tylerssims/psa_display_pedestal/README.md

# psa_display_pedestal
 Project files for a digital psa card display.
