tylerssims/psa_display_pedestal/psa_display_pedestal/drawings/.PNG/aluminum_pedestal_REVA.png

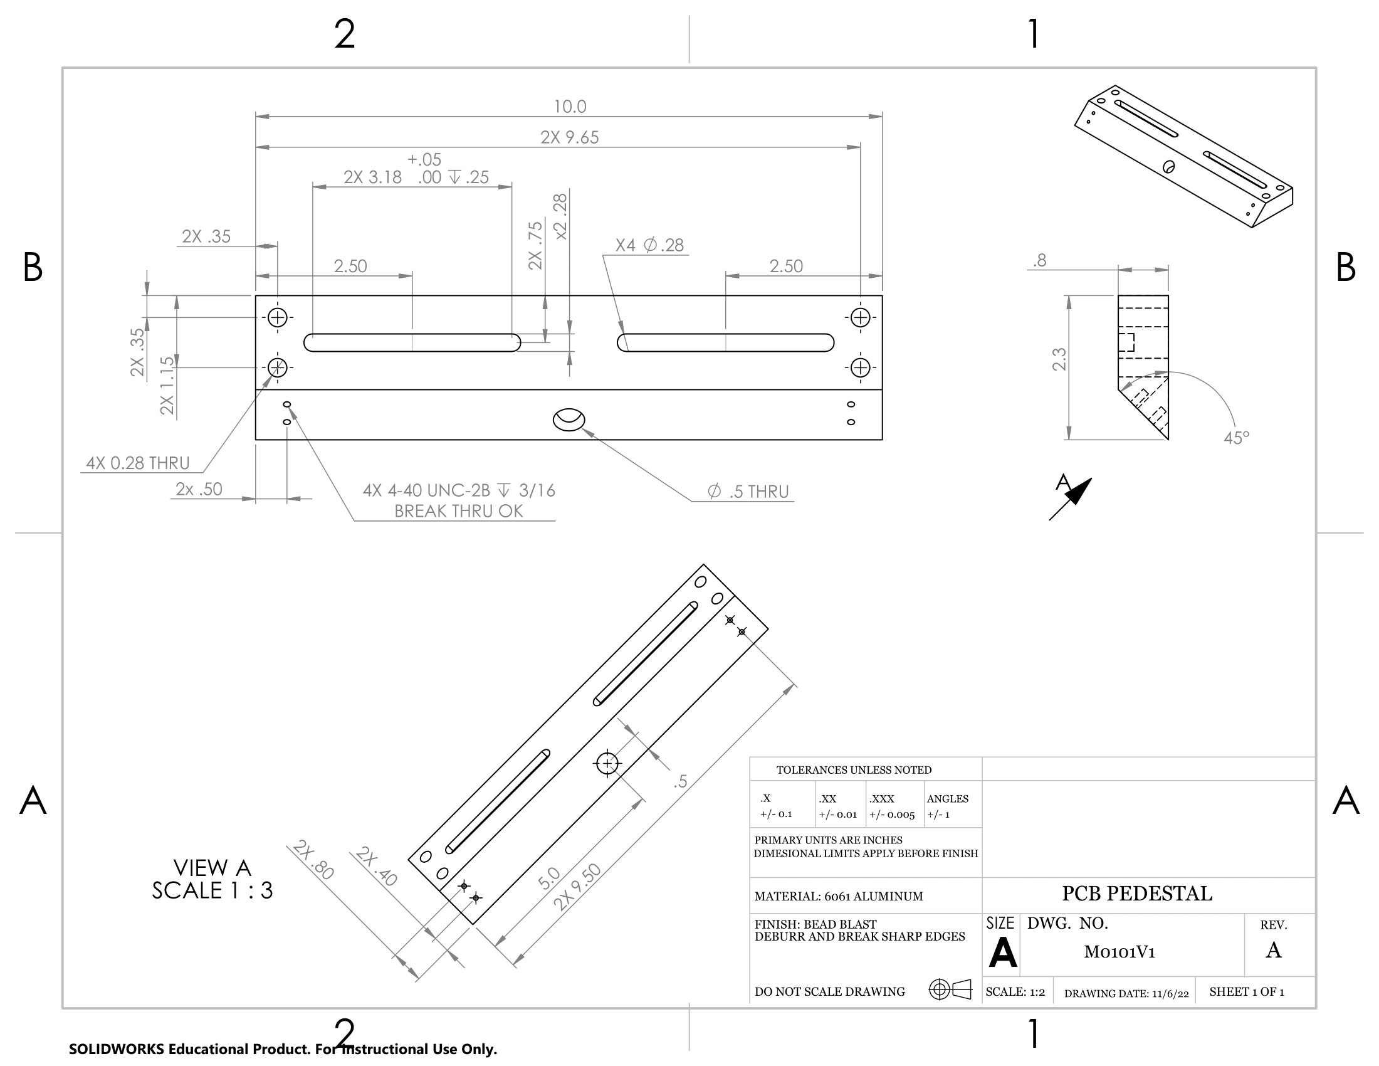
psa_display_pedestal/drawings/.PNG/aluminum_pedestal_REVA.png
