tylerssims/psa_display_pedestal/psa_display_pedestal/drawings/.PNG/front_panel_pcb_schematic_sch_bw.png

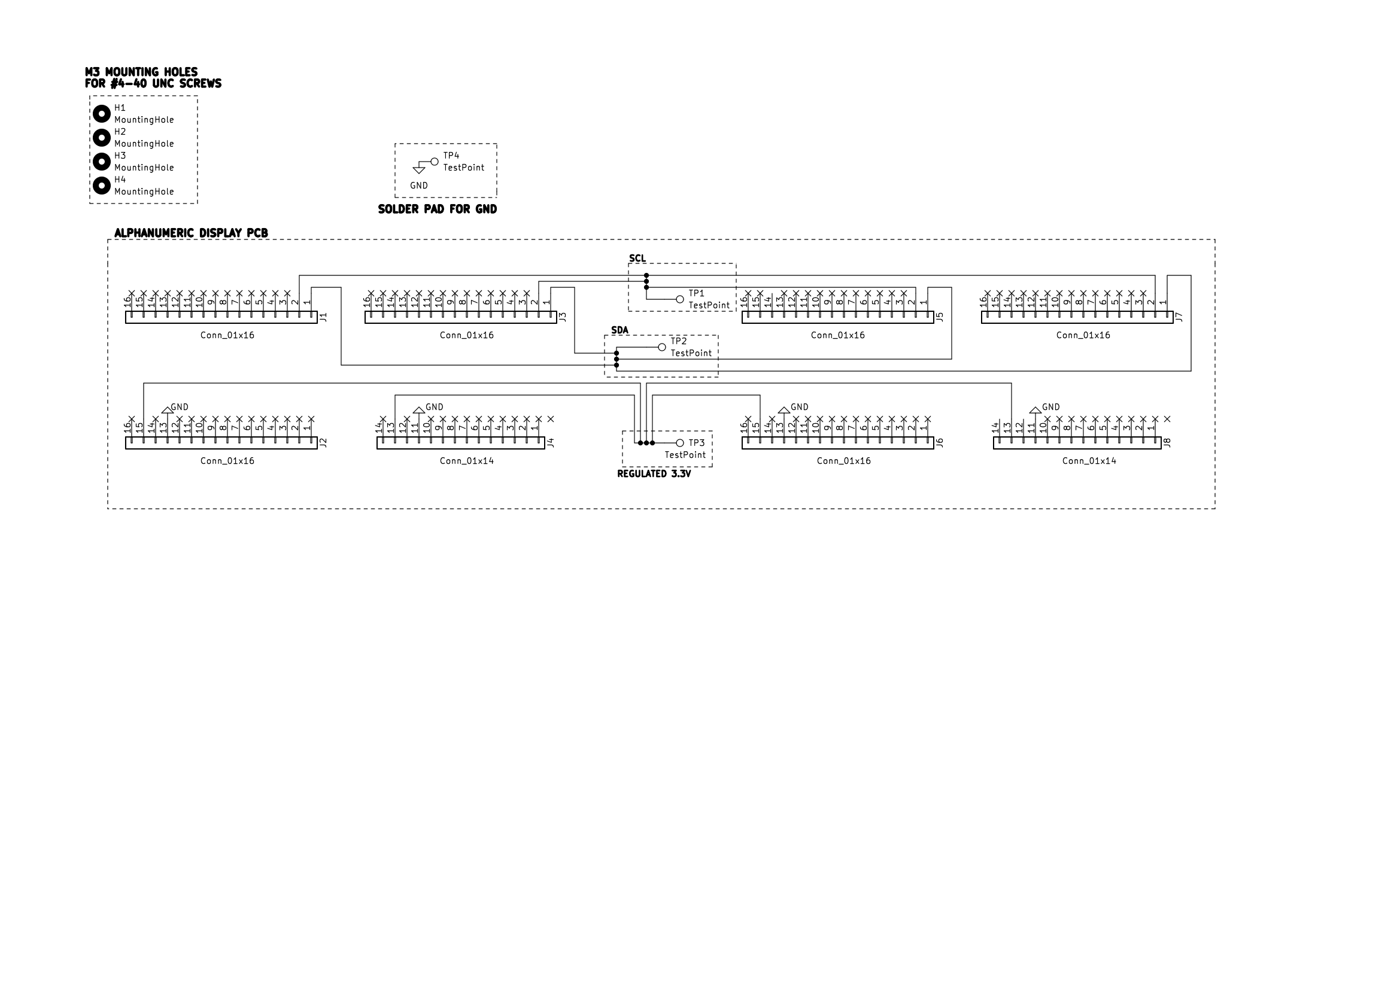
psa_display_pedestal/drawings/.PNG/front_panel_pcb_schematic_sch_bw.png
