tylerssims/psa_display_pedestal/psa_display_pedestal/drawings/.PNG/huzzah_control_pcb_sch_bw.png

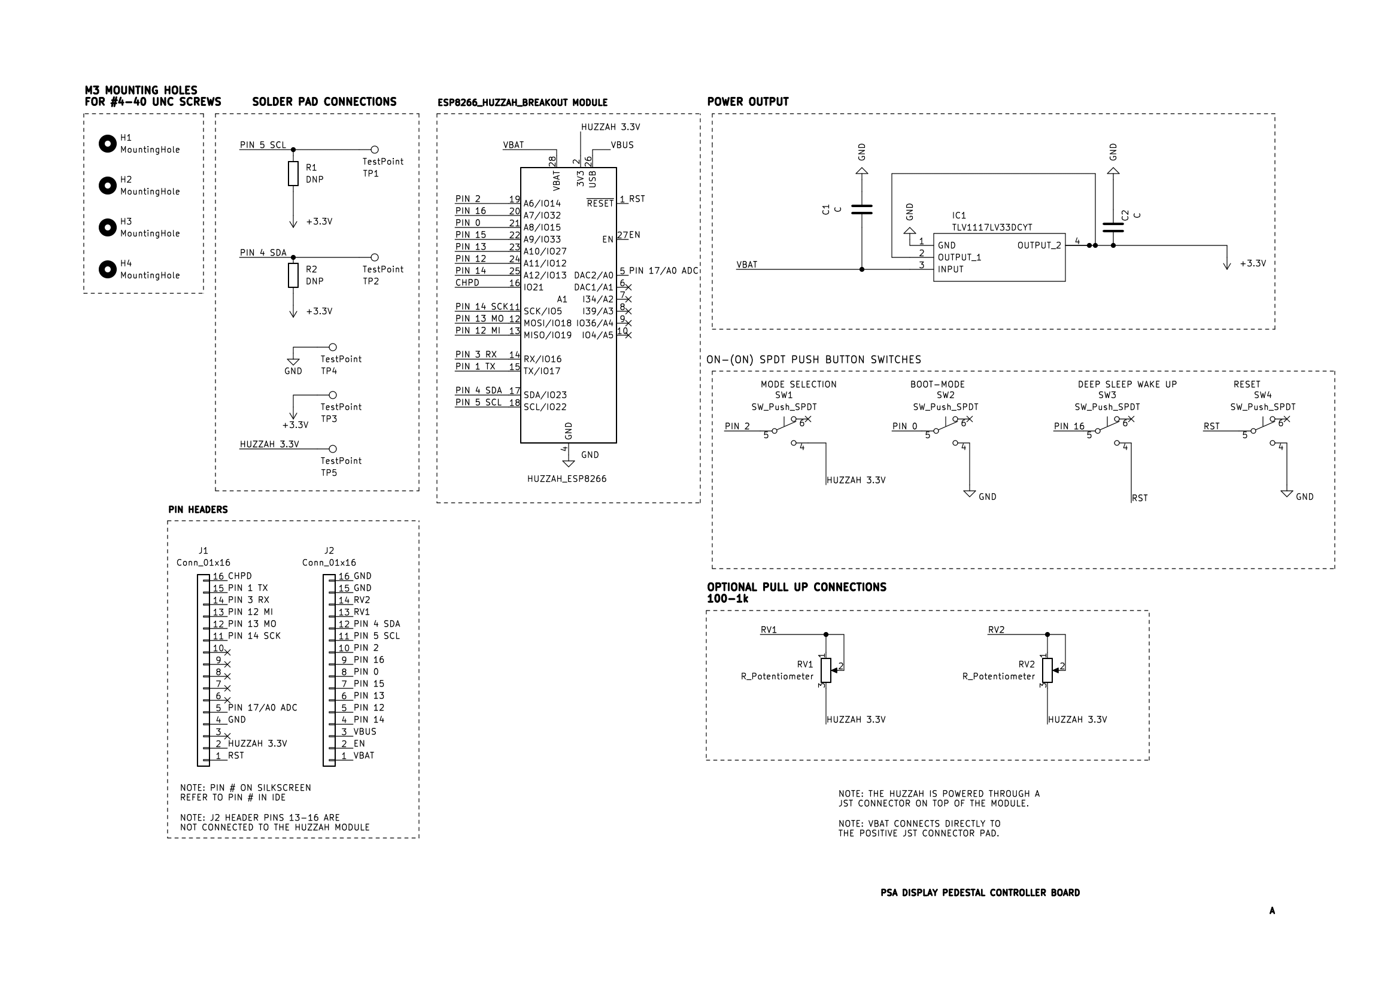
psa_display_pedestal/drawings/.PNG/huzzah_control_pcb_sch_bw.png
