tylerssims/psa_display_pedestal/psa_display_pedestal/drawings/.PNG/pla_back.png

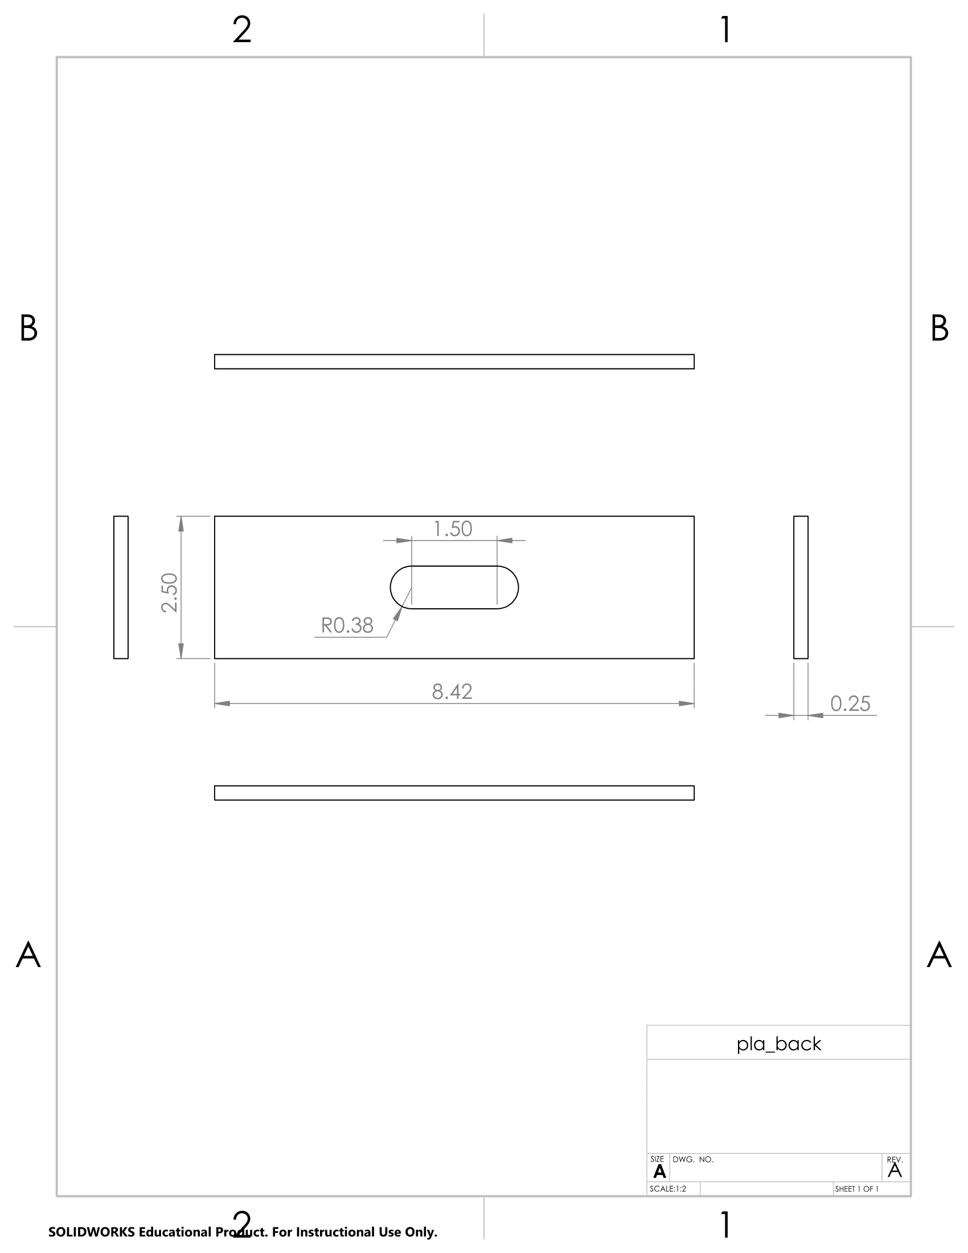
psa_display_pedestal/drawings/.PNG/pla_back.png
