tylerssims/psa_display_pedestal/psa_display_pedestal/drawings/.PNG/pla_side_LHS.png

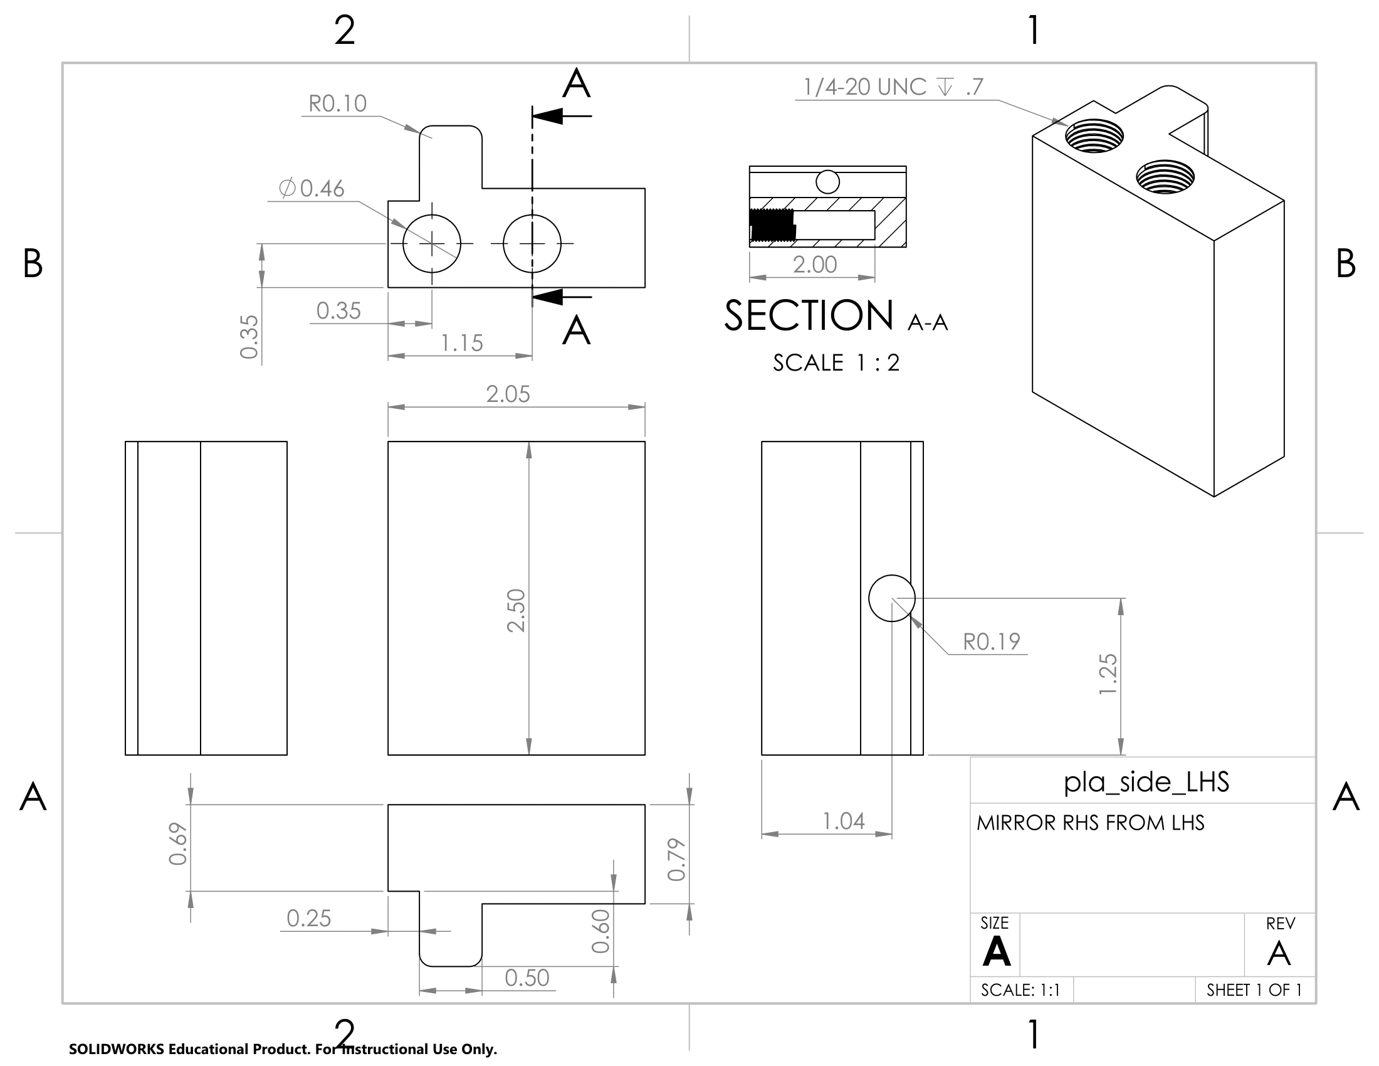
psa_display_pedestal/drawings/.PNG/pla_side_LHS.png
