tylerssims/psa_display_pedestal/psa_display_pedestal/drawings/.PNG/wood_bottom.png

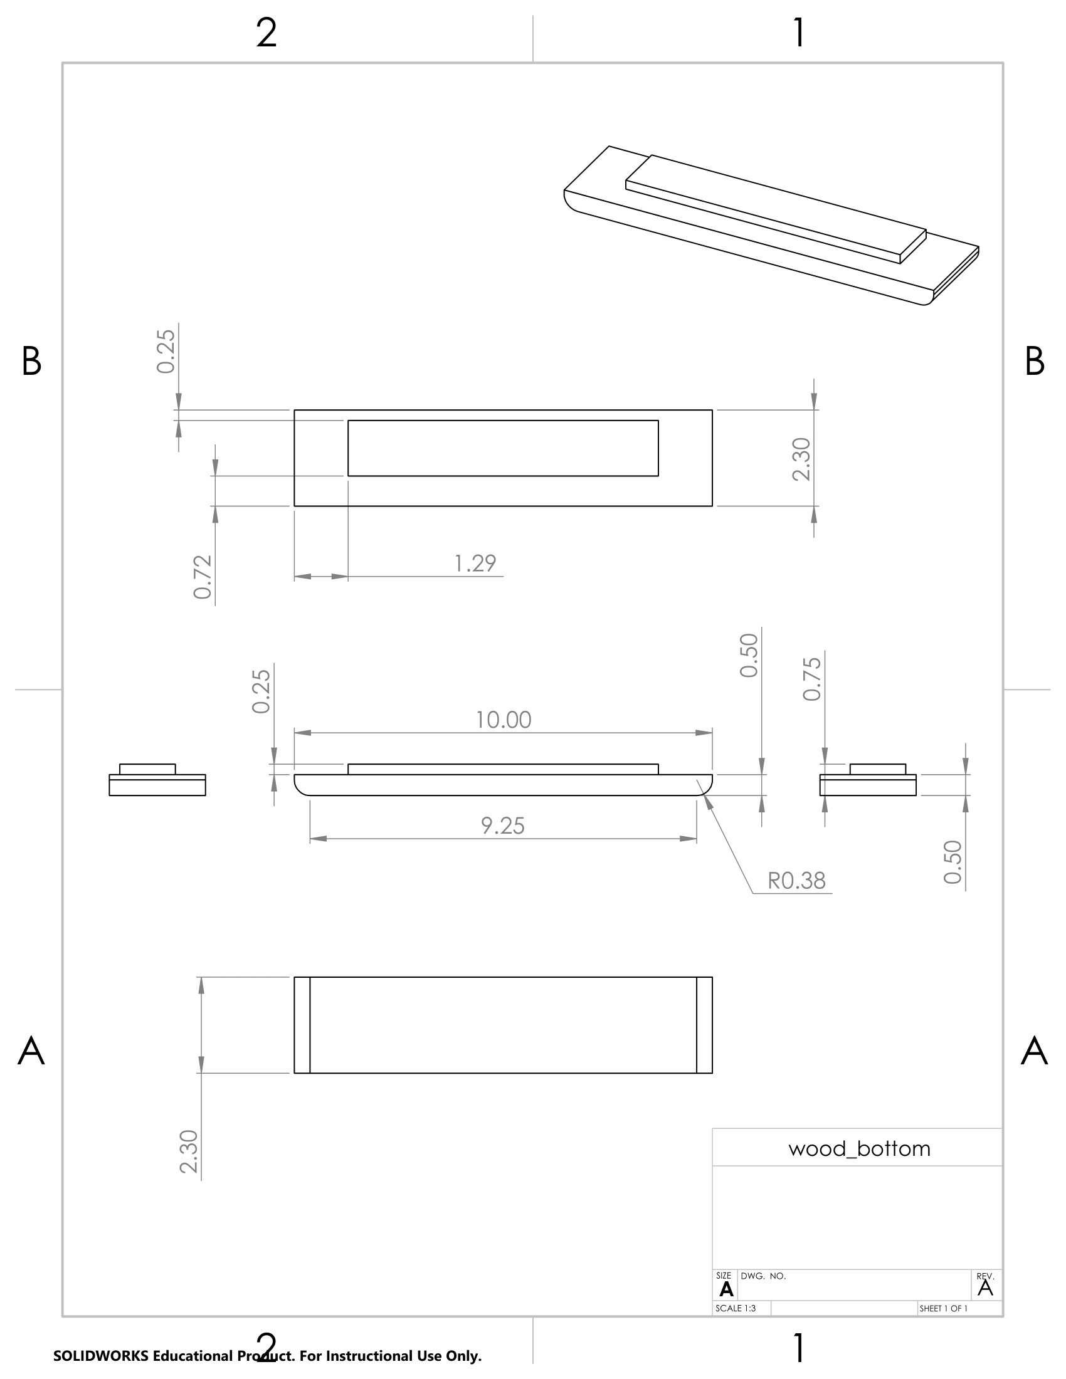
psa_display_pedestal/drawings/.PNG/wood_bottom.png
