tylerssims/psa_display_pedestal/psa_display_pedestal/drawings/.PNG/wood_front.png

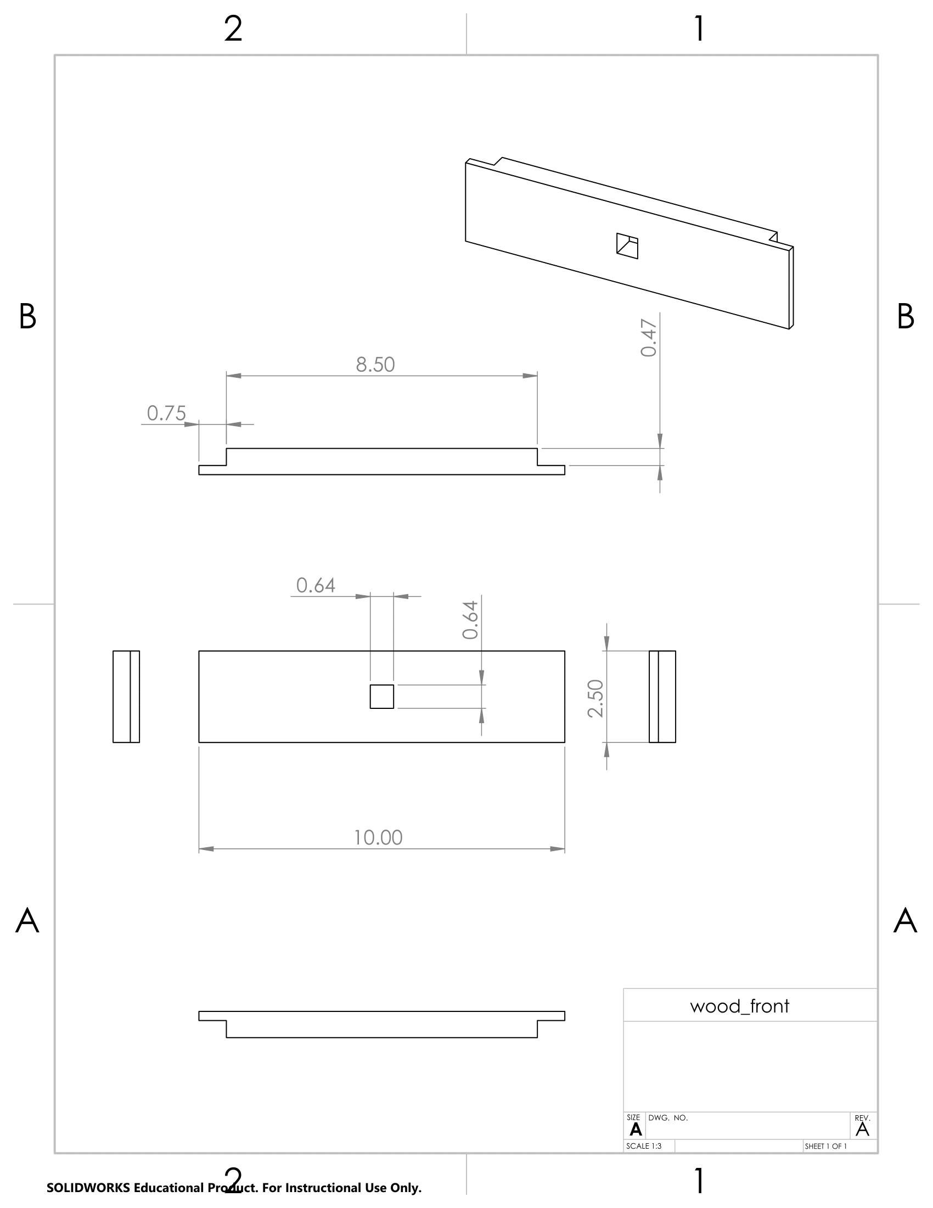
psa_display_pedestal/drawings/.PNG/wood_front.png
