tylerssims/psa_display_pedestal/psa_display_pedestal/images/BOM.png

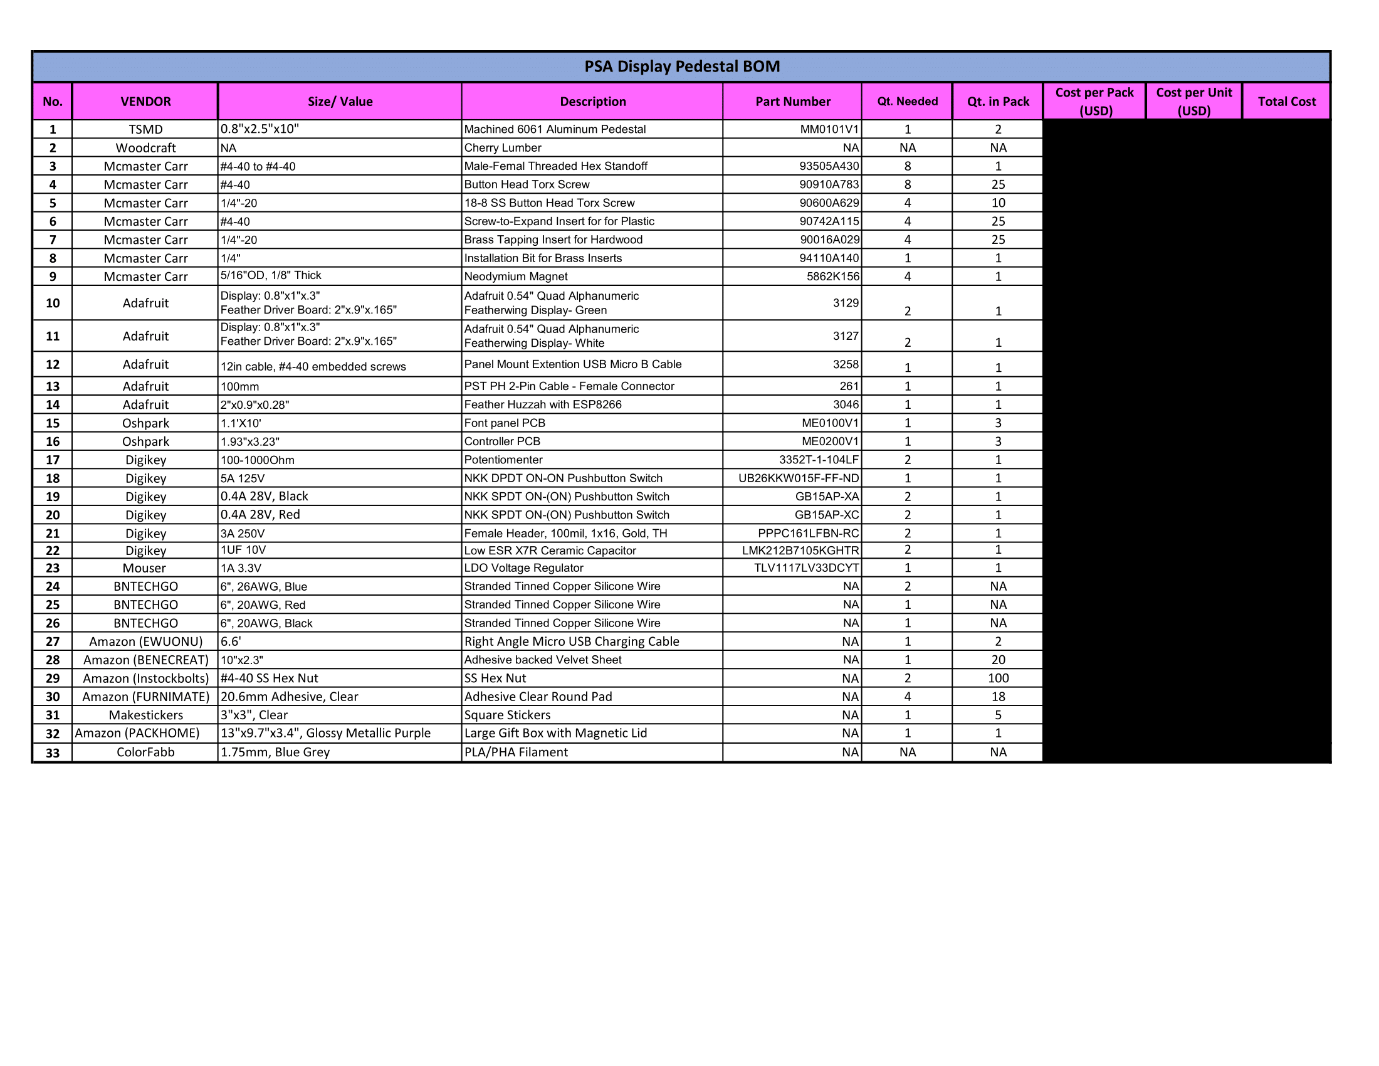
psa_display_pedestal/images/BOM.png
