tylerssims/psa_display_pedestal/psa_display_pedestal/3d_models/.SLDPRT/NKKSWITCHES_UB26KKW015FFF/UB26KKW015F_FF.sldasm

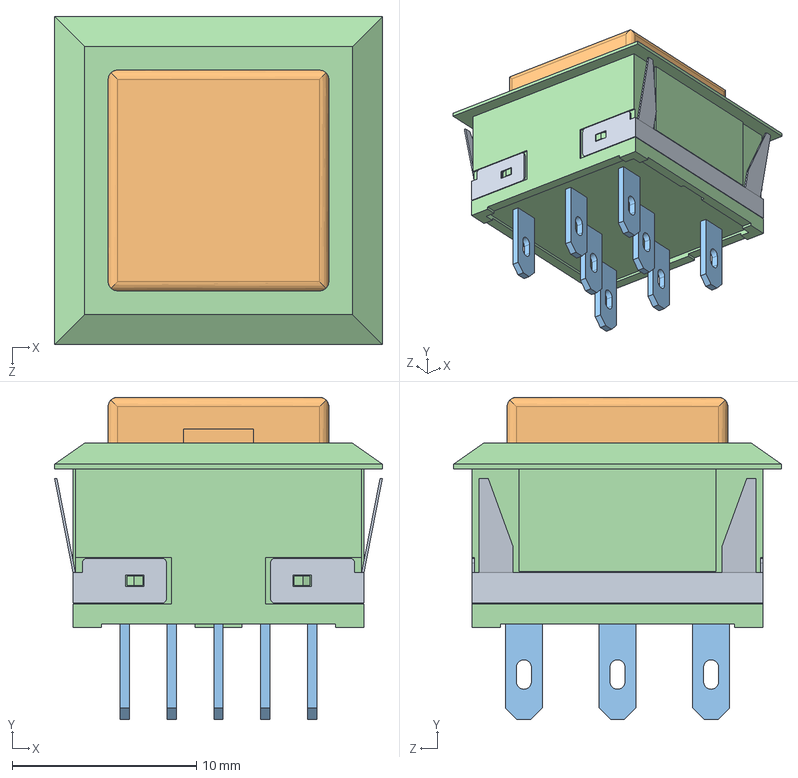
[picture p9: CAD file, 2023-03-03]
psa_display_pedestal/3d_models/.SLDPRT/NKKSWITCHES_UB26KKW015FFF/UB26KKW015F_FF.sldasm
17.8 x 17.5 x 17.8 mm
UB26KKW015F_FF_3 x 2
UB26KKW015F_FF_6
UB26KKW015F_FF_8 x 8
UB26KKW015F_FF_17
