tylerssims/psa_display_pedestal/psa_display_pedestal/3d_models/.SLDPRT/front_panel_assembly.SLDASM

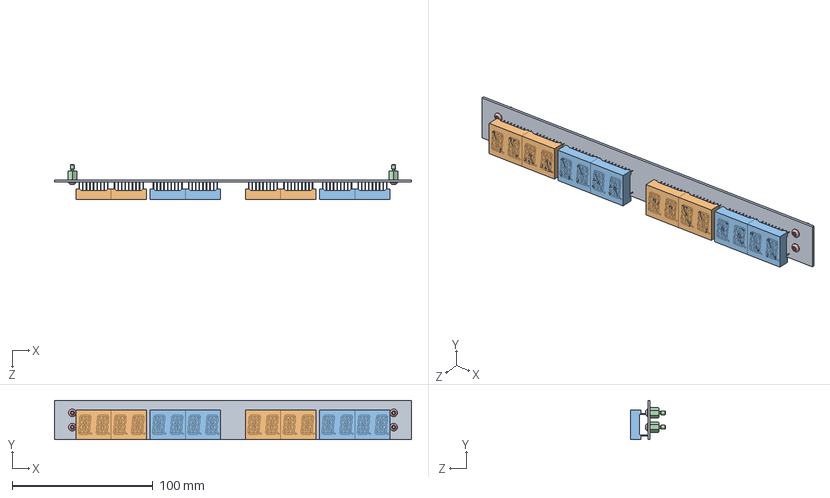
[picture p10: CAD file, 2023-03-03]
psa_display_pedestal/3d_models/.SLDPRT/front_panel_assembly.SLDASM
254.0 x 27.9 x 25.2 mm
front_panel_pcb
14segment_green x 4
14segment_white x 4
4-40_threaded_hex_standoff x 4
4-40_button_head_torx_screw x 4
