tylerssims/psa_display_pedestal/psa_display_pedestal/3d_models/.SLDPRT/pedestal_assembly.SLDASM

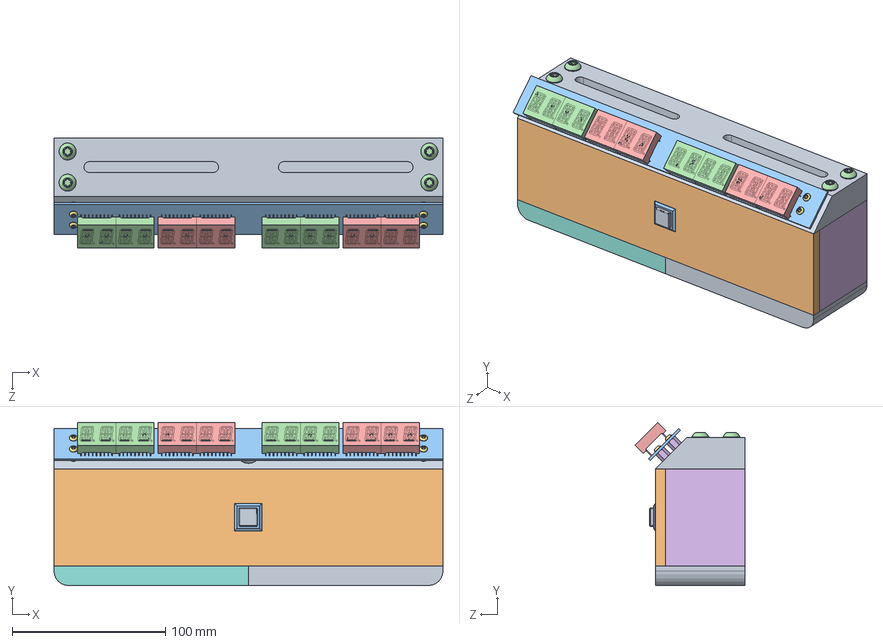
[picture p11: CAD file, 2023-03-03]
psa_display_pedestal/3d_models/.SLDPRT/pedestal_assembly.SLDASM
254.0 x 106.5 x 71.9 mm
aluminum_pedestal
front_panel_pcb
14segment_green x 4
14segment_white x 4
4-40_threaded_hex_standoff x 4
4-40_button_head_torx_screw x 4
UB26KKW015F_FF_3 x 2
UB26KKW015F_FF_6
UB26KKW015F_FF_8 x 8
UB26KKW015F_FF_17
0.25-20_button_head_torx_screw x 4
pla_side_LHS
pla_side_RHS
pla_back
pla_bottom_LHS
pla_bottom_RHS
