tylerssims/psa_display_pedestal/psa_display_pedestal/3d_models/.SLDPRT/pla_bottom_assembly.SLDASM

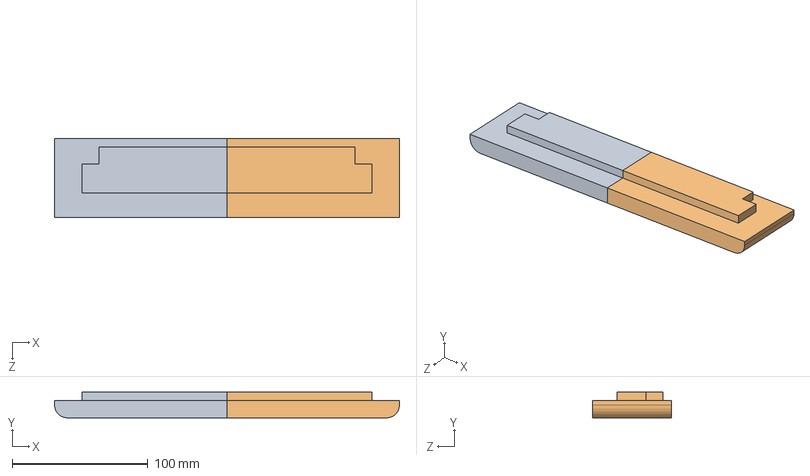
[picture p12: CAD file, 2023-03-03]
psa_display_pedestal/3d_models/.SLDPRT/pla_bottom_assembly.SLDASM
254.0 x 19.1 x 58.4 mm
pla_bottom_LHS
pla_bottom_RHS
