tylerssims/psa_display_pedestal/psa_display_pedestal/3d_models/.SLDPRT/neonymium_magnets.SLDPRT

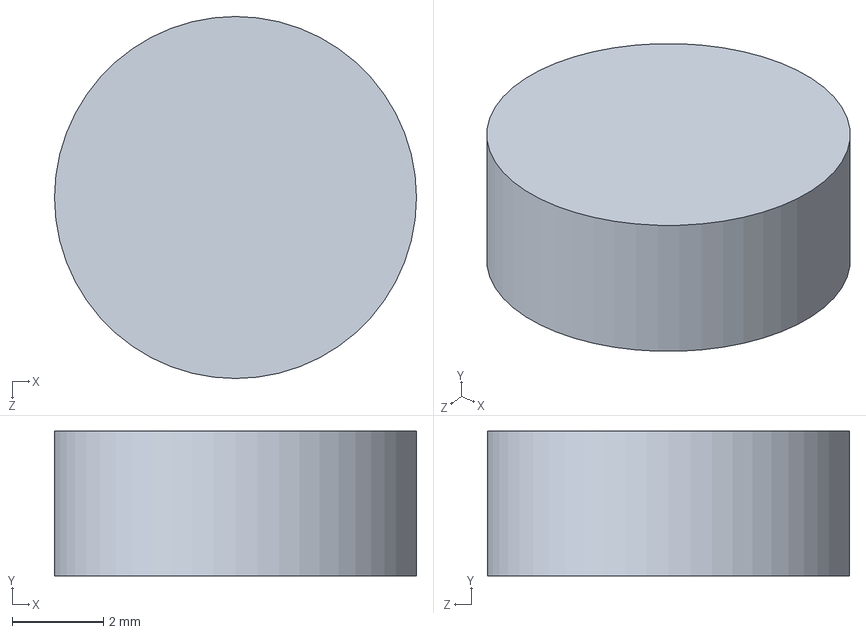
[picture p13: CAD file, 2023-03-03]
psa_display_pedestal/3d_models/.SLDPRT/neonymium_magnets.SLDPRT
7.94 x 3.17 x 7.94 mm
