tylerssims/psa_display_pedestal/psa_display_pedestal/3d_models/.SLDPRT/NKKSWITCHES_UB26KKW015FFF/wood_bottom.SLDPRT

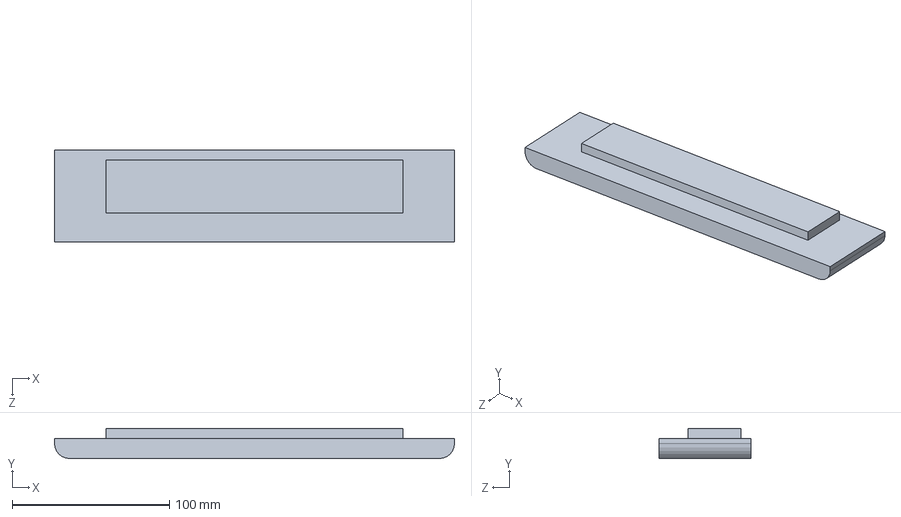
[picture p14: CAD file, 2023-03-03]
psa_display_pedestal/3d_models/.SLDPRT/NKKSWITCHES_UB26KKW015FFF/wood_bottom.SLDPRT
254.0 x 19.1 x 58.4 mm
