tylerssims/psa_display_pedestal/psa_display_pedestal/3d_models/.SLDPRT/pla_side_RHS.SLDPRT

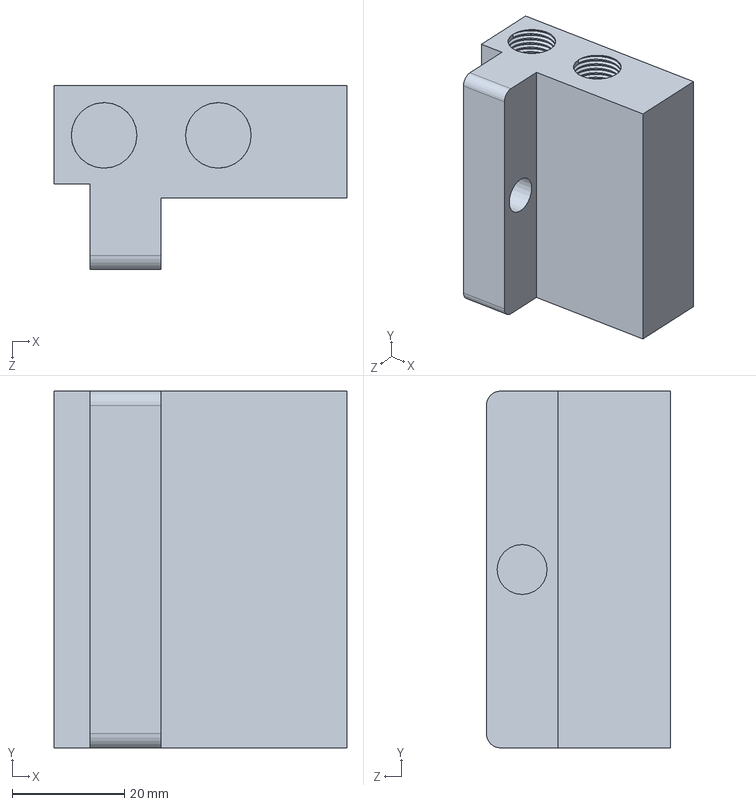
[picture p15: CAD file, 2023-03-03]
psa_display_pedestal/3d_models/.SLDPRT/pla_side_RHS.SLDPRT
52.1 x 63.5 x 32.8 mm
