tylerssims/psa_display_pedestal/psa_display_pedestal/3d_models/.SLDPRT/front_panel_pcb.SLDPRT

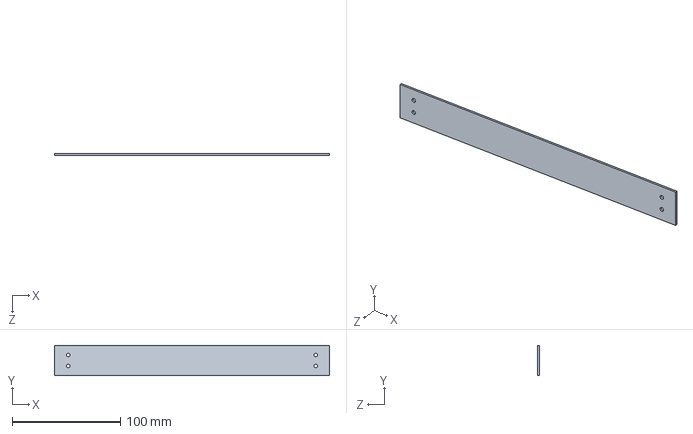
[picture p16: CAD file, 2023-03-03]
psa_display_pedestal/3d_models/.SLDPRT/front_panel_pcb.SLDPRT
254.0 x 27.9 x 1.64 mm
