tylerssims/psa_display_pedestal/psa_display_pedestal/3d_models/.SLDPRT/4-40_threaded_hex_standoff.SLDPRT

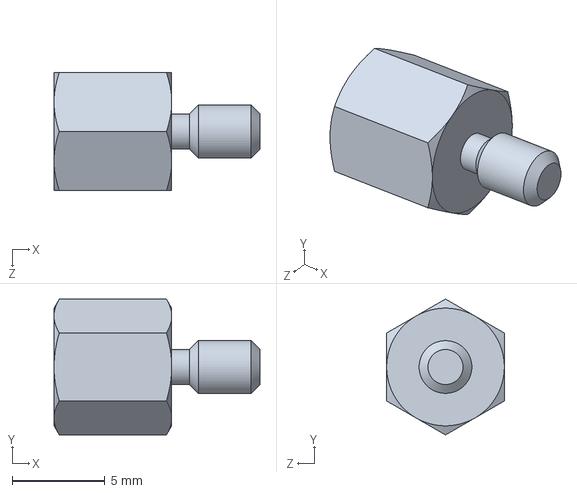
[picture p17: CAD file, 2023-03-03]
psa_display_pedestal/3d_models/.SLDPRT/4-40_threaded_hex_standoff.SLDPRT
11.1 x 7.33 x 6.35 mm
