tylerssims/psa_display_pedestal/psa_display_pedestal/3d_models/.SLDPRT/wood_front.SLDPRT

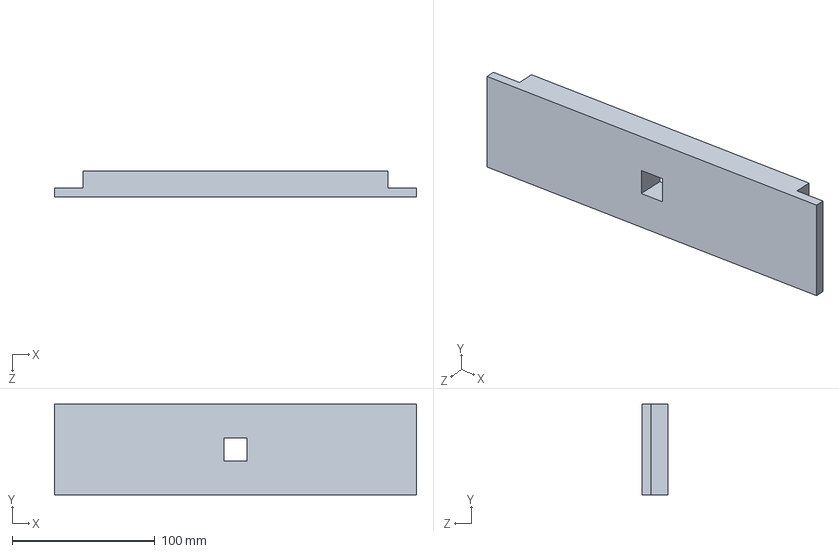
[picture p18: CAD file, 2023-03-03]
psa_display_pedestal/3d_models/.SLDPRT/wood_front.SLDPRT
254.0 x 63.5 x 18.3 mm
