tylerssims/psa_display_pedestal/psa_display_pedestal/3d_models/.SLDPRT/14segment_white.SLDPRT

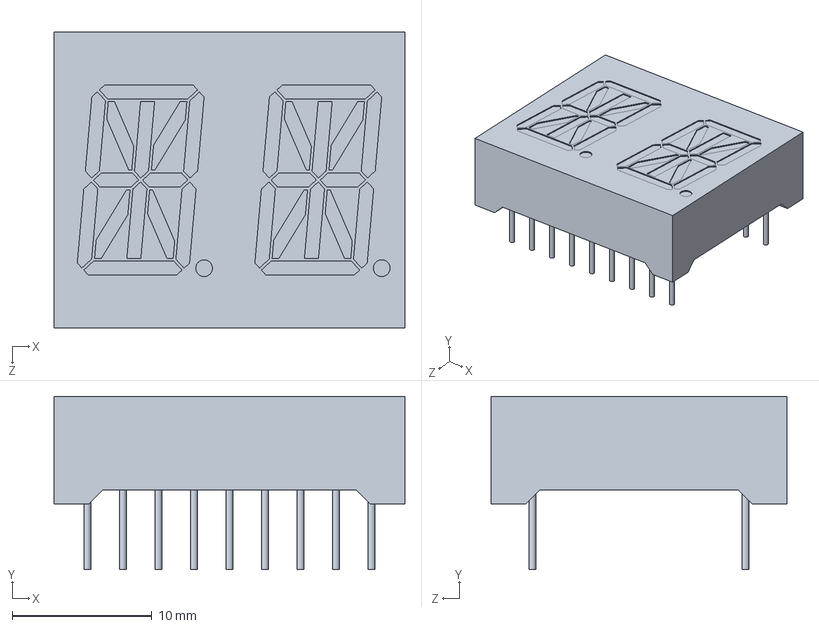
[picture p19: CAD file, 2023-03-03]
psa_display_pedestal/3d_models/.SLDPRT/14segment_white.SLDPRT
25.1 x 12.4 x 21.2 mm
