tylerssims/psa_display_pedestal/psa_display_pedestal/3d_models/.SLDPRT/pla_bottom_RHS.SLDPRT

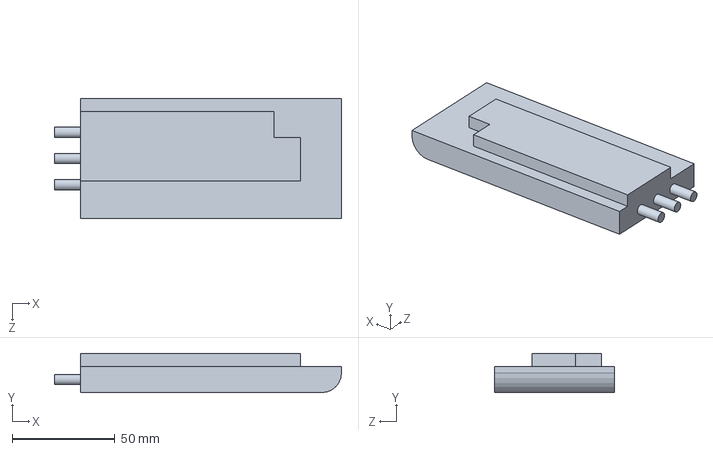
[picture p20: CAD file, 2023-03-03]
psa_display_pedestal/3d_models/.SLDPRT/pla_bottom_RHS.SLDPRT
139.7 x 19.1 x 58.4 mm
