tylerssims/psa_display_pedestal/psa_display_pedestal/3d_models/.SLDPRT/pla_bottom_LHS.SLDPRT

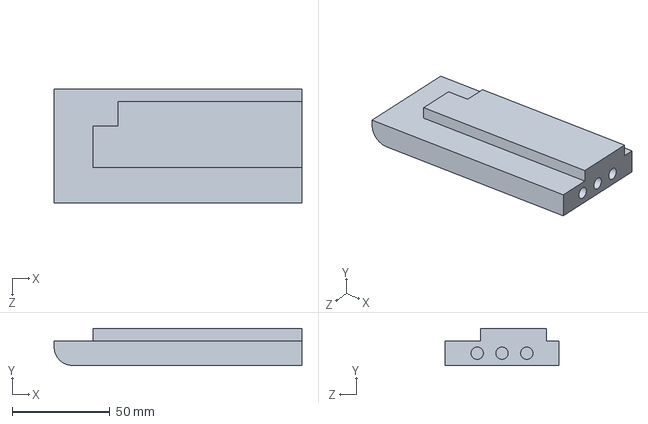
[picture p21: CAD file, 2023-03-03]
psa_display_pedestal/3d_models/.SLDPRT/pla_bottom_LHS.SLDPRT
127.0 x 19.1 x 58.4 mm
