tylerssims/psa_display_pedestal/psa_display_pedestal/3d_models/.SLDPRT/pla_back.SLDPRT

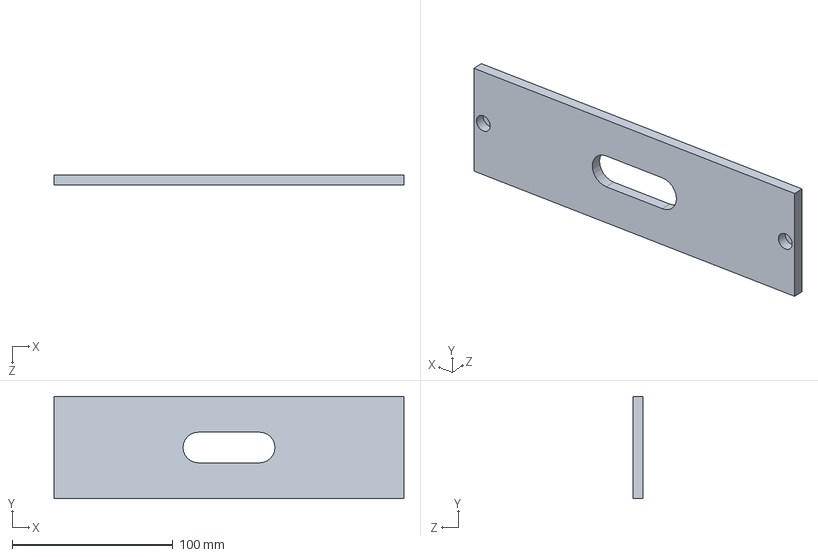
[picture p22: CAD file, 2023-03-03]
psa_display_pedestal/3d_models/.SLDPRT/pla_back.SLDPRT
217.7 x 63.5 x 6.35 mm
