tylerssims/psa_display_pedestal/(list of files, cad)

Other CAD files:
psa_display_pedestal/3d_models/.SLDPRT/NKKSWITCHES_UB26KKW015FFF/UB26KKW015F_FF_6.sldprt
psa_display_pedestal/3d_models/.STEP/aluminum_pedestal.STEP
psa_display_pedestal/3d_models/.SLDPRT/NKKSWITCHES_UB26KKW015FFF/UB26KKW015F_FF_3.sldprt
psa_display_pedestal/3d_models/.SLDPRT/NKKSWITCHES_UB26KKW015FFF/UB26KKW015F_FF_17.sldprt
psa_display_pedestal/3d_models/.SLDPRT/NKKSWITCHES_UB26KKW015FFF/UB26KKW015F_FF_8.sldprt
psa_display_pedestal/3d_models/.SLDPRT/pla_side_LHS.SLDPRT
psa_display_pedestal/3d_models/.SLDPRT/14segment.SLDPRT
psa_display_pedestal/3d_models/.SLDPRT/14segment_green.SLDPRT
psa_display_pedestal/3d_models/.SLDPRT/0.25-20_button_head_torx_screw.SLDPRT
psa_display_pedestal/3d_models/.SLDPRT/4-40_button_head_torx_screw.SLDPRT
psa_display_pedestal/3d_models/.SLDPRT/aluminum_pedestal.SLDPRT
psa_display_pedestal/drawings/.SLDDRW/aluminum_pedestal_REVA.SLDDRW
psa_display_pedestal/drawings/.SLDDRW/pedestal_assembly.SLDDRW
psa_display_pedestal/drawings/.SLDDRW/pla_back.SLDDRW
psa_display_pedestal/drawings/.SLDDRW/pla_side_LHS.SLDDRW
psa_display_pedestal/drawings/.SLDDRW/wood_bottom.SLDDRW
psa_display_pedestal/drawings/.SLDDRW/wood_front.SLDDRW
