tylerssims/psa_display_pedestal/psa_display_pedestal/PSA Display Pedestal Manual.pdf

# OPERATION MANUAL

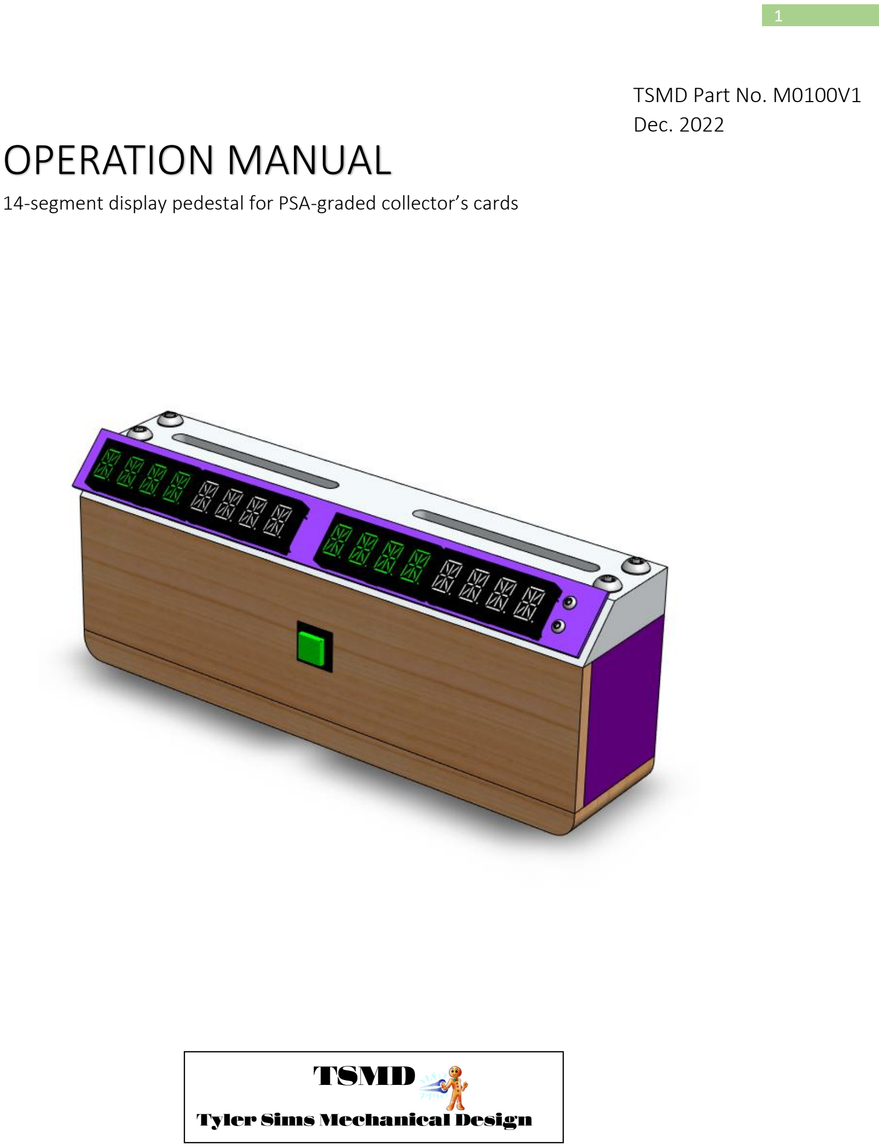
[picture p23: page 1]

## TSMD

Tyler Sims Mechanical Design

14-segment display pedestal for PSA-graded collector’s cards

TSMD Part No. M0100V1
Dec. 2022

### Use of Operation Manual

Please read through and understand this Operation Manual before operating the product. After reading, always keep the manual nearby so that you may refer to it as needed.

If you find any misplaced or missing pages in this manual, they will be replaced. If the manual gets lost or soiled, a new copy can be provided for a fee. In either case, please get in touch with your TSMD distributor/agent, and provide the “TSMD Part No.” given on the cover.

This manual, alongside all other documentation, can be found in our GitHub repository at:

https://github.com/tylerssims/PSA_Display_Pedestal

This manual has been prepared with the utmost care; however, if you have any questions or note any errors or omissions, please see our GitHub page for contact information.

### How to Read This Manual

### Preface

Thank you for your support! We do hope that you find the enclosed PSA Display Pedestal to your satisfaction.

(Hereafter abbreviated as Pedestal).

This manual is intended for first-time users of the Pedestal. It gives an overview of the product and describes various settings, operating, maintenance, safety precautions, etc.

Read through this manual thoroughly to use the function of the Pedestal effectively. You can also review this manual; when you are confused about an operation or when a problem occurs.

Shall you remain confused for more than 4 hours, please stop using the Pedestal and consult your doctor.

### How to read this manual

This manual is designed to be read from beginning to end.

### Intended readers of this manual

This manual is intended for those using the Pedestal, but those not using it can read it too. For those reading this manual in the latter group, please get in touch with your TSMD distributor/agent to purchase a Pedestal.

### The notation used in this manual:

The following marks are used with the corresponding explanations in this manual.

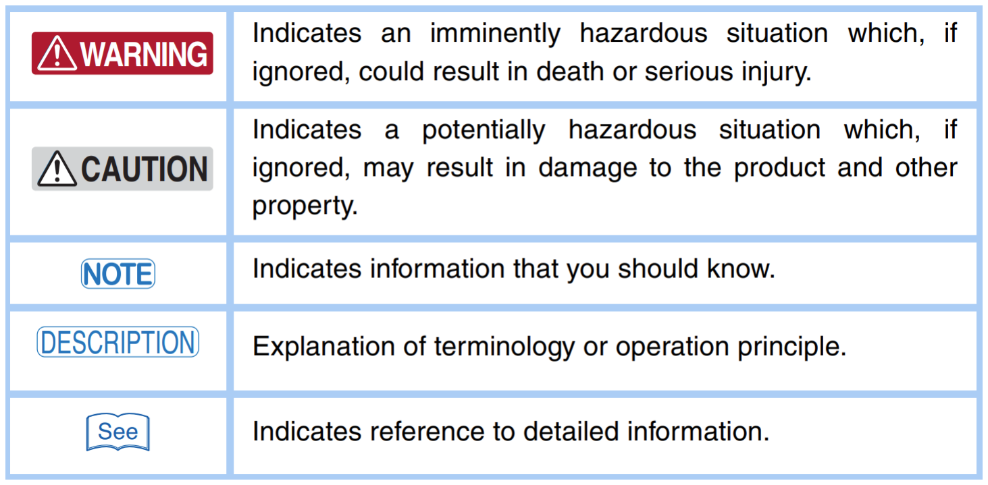
[picture p24: figure]

## Section 1: General Description

This chapter gives an overview and introduces the features of the Pedestal.

1.1 Product Overview The PSA Display Pedestal is a high-performance digital display pedestal that displays the current value of the card alongside the current population count. Adopting an ESP8266 on the control module allows the Pedestal to update its cost and population data over a wireless network.

### 1.2 Features

| • 6061 Aluminum top with two slots for standard PSA-graded cases • Made in the USA • Cherry base • Made in the USA • Stainless Steel hardware • Purple velvet PLA/ PHA 3D printed rear panel • Purple Printed circuit boards from Oshpark LLC • Made in the USA • Four pairs of 14-segment alphanumeric displays • Two pairs of green displays • Two pairs of white display units • NKK Switches • Battery powered operation • Molicel M35A 18650 3500mAh protected button top cells • 7000mAh total ampacity • USB charging • WIFI integrated ESP8266 microcontroller • Live value and population updates through an online server

Documentation on all features can be found in the GitHub PSA Display Pedestal repository.

DO NOT MODIFY THE BATTERY PACK. Doing so may damage the cells and cause them to catch fire. Lithium-ion battery fires are very dangerous. Water may not prevent a battery from burning and spreading. Battery cells are known to explode and quickly spread to another battery. It can spread to other devices.

## Section 2: Device Operation

This section gives a quick reference on how to use the features of the Pedestal.

### 2.1 Power

The Pedestal is powered via a USB cable which supplies 5V power to the control board. The integrated Lithium-Ion battery pack can power the display continuously in its highest power state for 24 hours. It is vital that the USB power block used to plug into the wall is a high-quality unit with a stable 5V DC output.

The control board has an integrated circuit on the Huzzah module to handle the charging of the Li-ion cells. The cells are also individually protected with button-top protection circuits. Should an issue arise with the battery pack, unplug the JST connector on the Huzzah module and remove the battery pack. The Pedestal will still retain power through the USB port.

### 2.2 Display Modes

The Pedestal has three operation modes.

### 1. Continuous Operation 2. Power Saver 3. Ultra-Power Saver

In Mode 1, Continuous Operation Mode, the displays will remain on indefinitely when the green push button is activated. The device will connect to the server once every 30 minutes to update.

In Mode 2, Power Saver Mode, the displays will remain on indefinitely when the green push button is activated. The device will connect to the server once every 24 hours to update.

In Mode 3, Ultra-Power Saver Mode, the displays will remain on indefinitely when the green push button is activated. The device’s WIFI connectivity will be switched off, and the device will not update until switched into mode 1 or 2.

Push button 1 (SW1) on the Huzzah Control PCB cycles between the modes. The switch is labeled on the PCB silkscreen.

### 2.3 Switches

The Pedestal features 5 NKK push button switches:

- 1 ON-ON DPDT push button switch
- Green without illumination
- Located on the front of the Pedestal
- 4 ON-(ON) SPDT push button switch
- Two red, two black, without illumination
- Located on the control board

The main green push button is used to turn the displays on-off.

See pg. 14 for the Huzzah Breakout PCB layout.

## Section 3: Design Files

This section contains the drawing required to produce the components designed by TSMD. Further documentation is available in the PSA Display Pedestal GitHub repository.

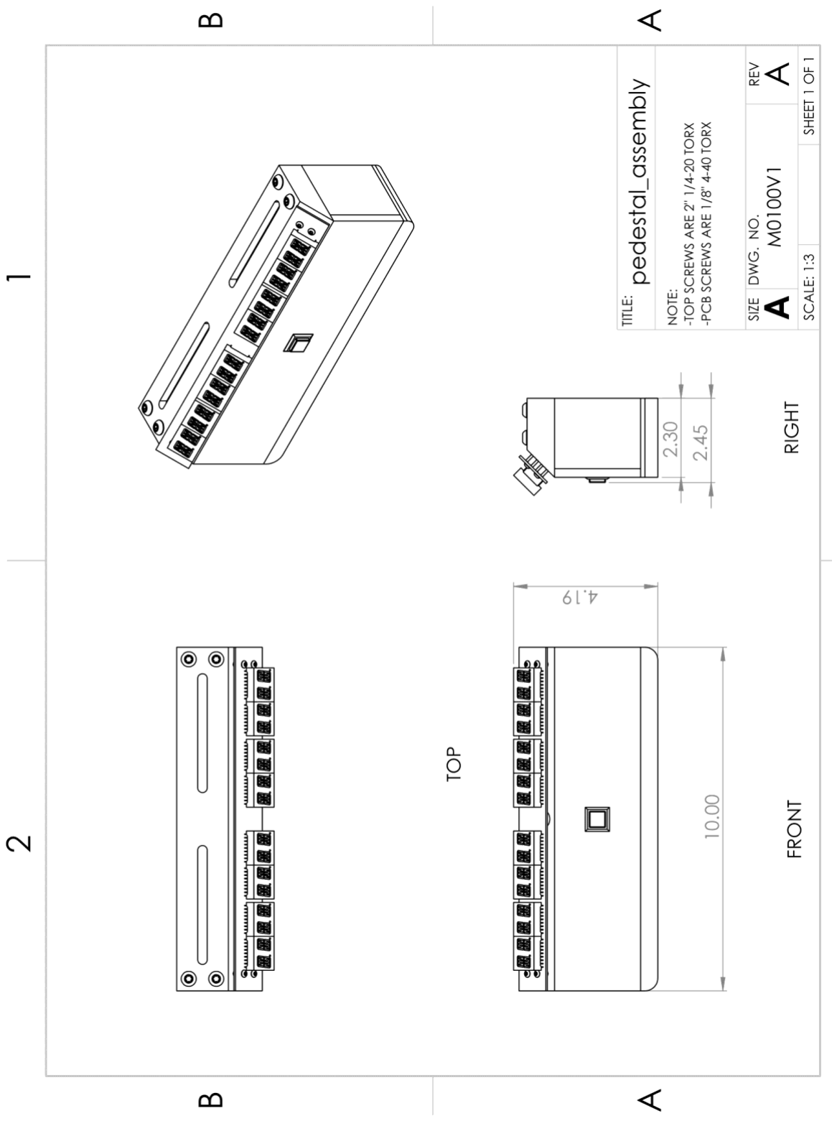
[picture p25: figure]

Section 3.1: Complete Assembly Drawing

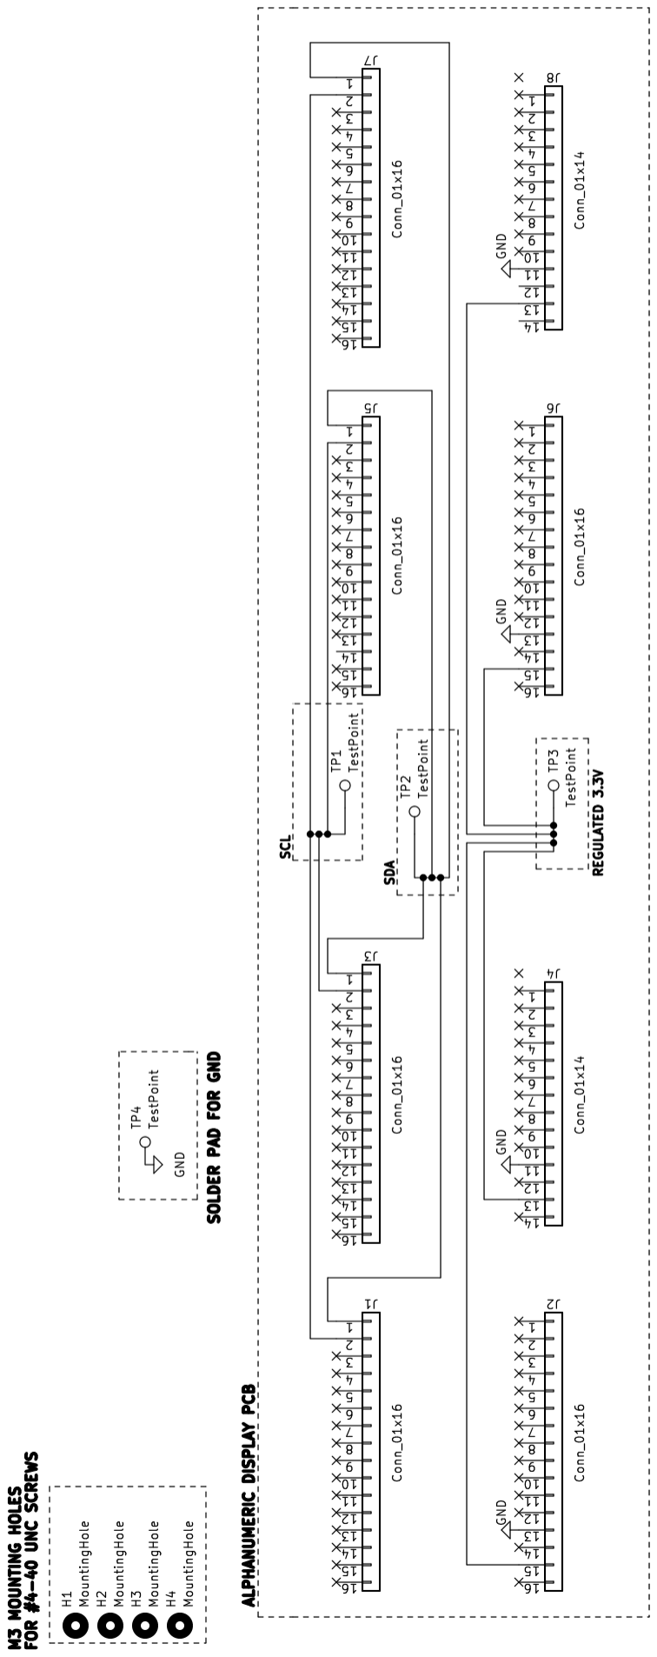
[picture p26: figure]

### Section 3.2: Front Panel PCB

Section 3.2.1: Schematic

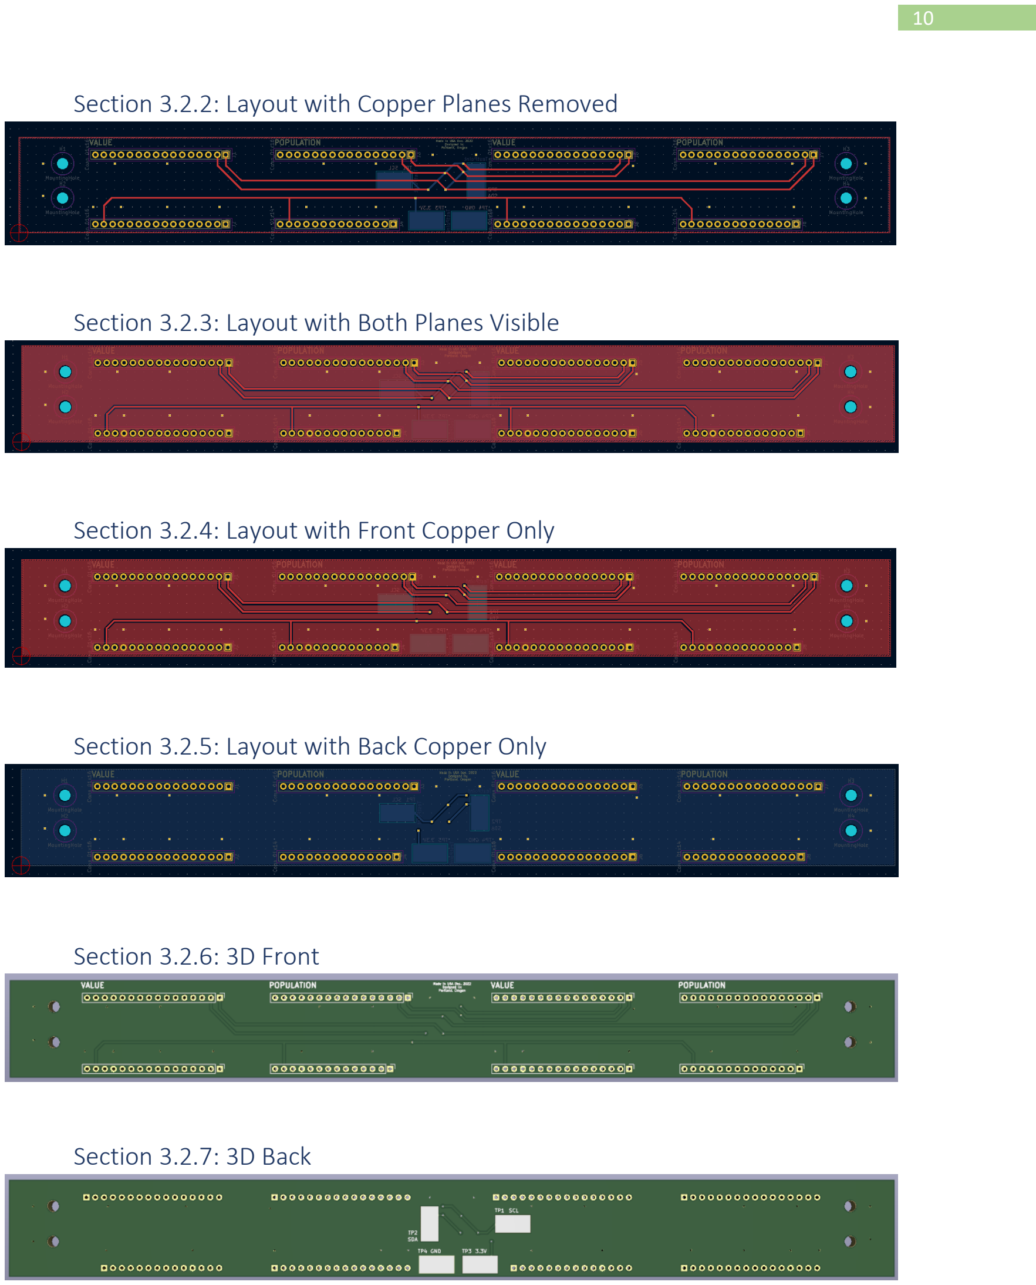
[picture p27: page 10]

Section 3.2.2: Layout with Copper Planes Removed

Section 3.2.3: Layout with Both Planes Visible

Section 3.2.4: Layout with Front Copper Only

Section 3.2.5: Layout with Back Copper Only

Section 3.2.6: 3D Front

Section 3.2.7: 3D Back

### Section 3.3: Huzzah Control PCB

Section 3.3.1: Schematic

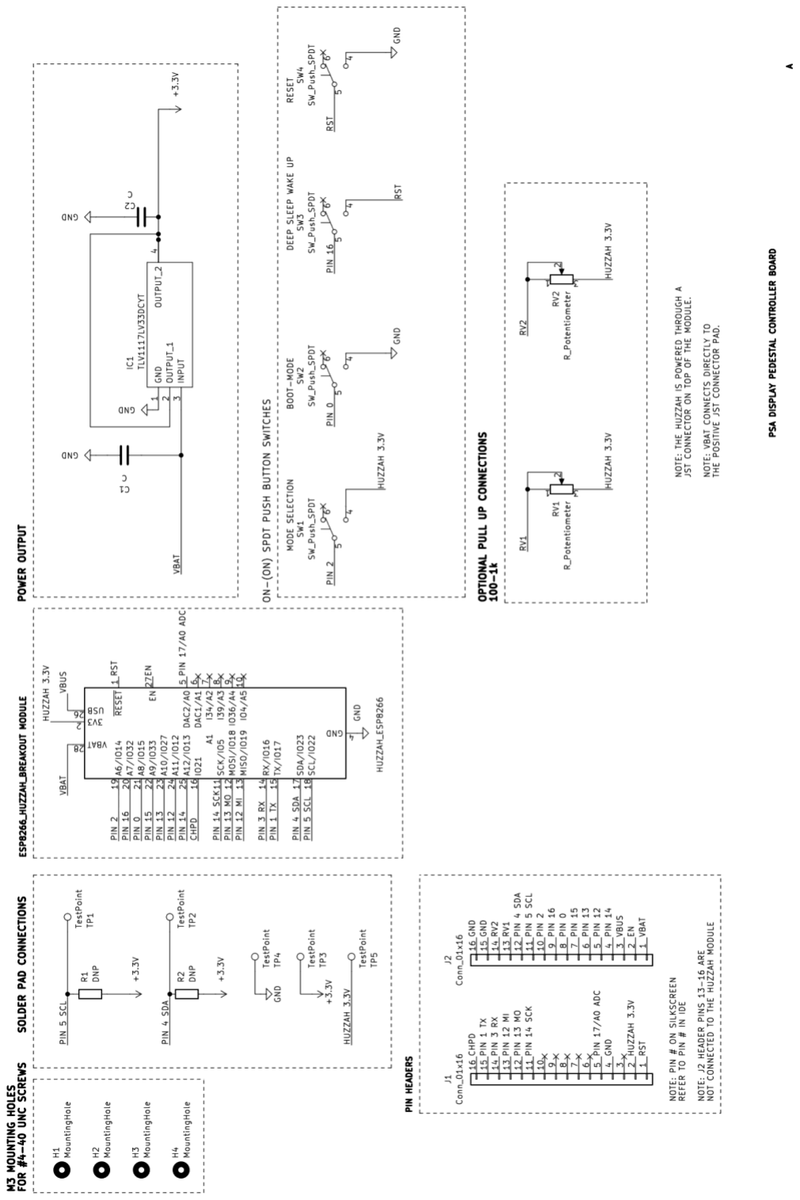
[picture p28: figure]
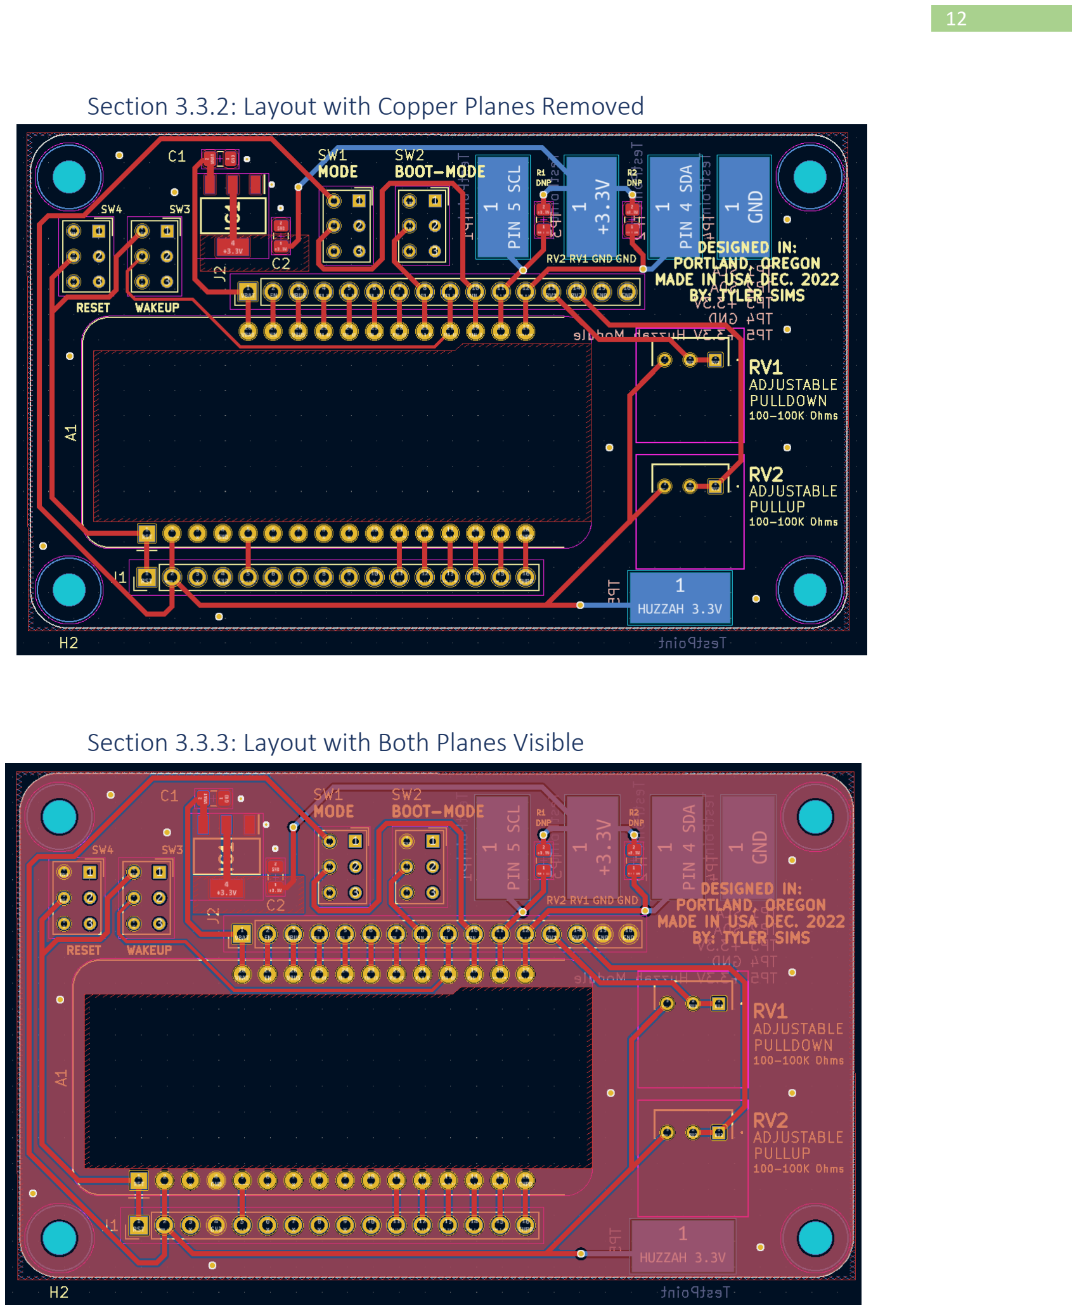
[picture p29: page 12]

Section 3.3.2: Layout with Copper Planes Removed

Section 3.3.3: Layout with Both Planes Visible

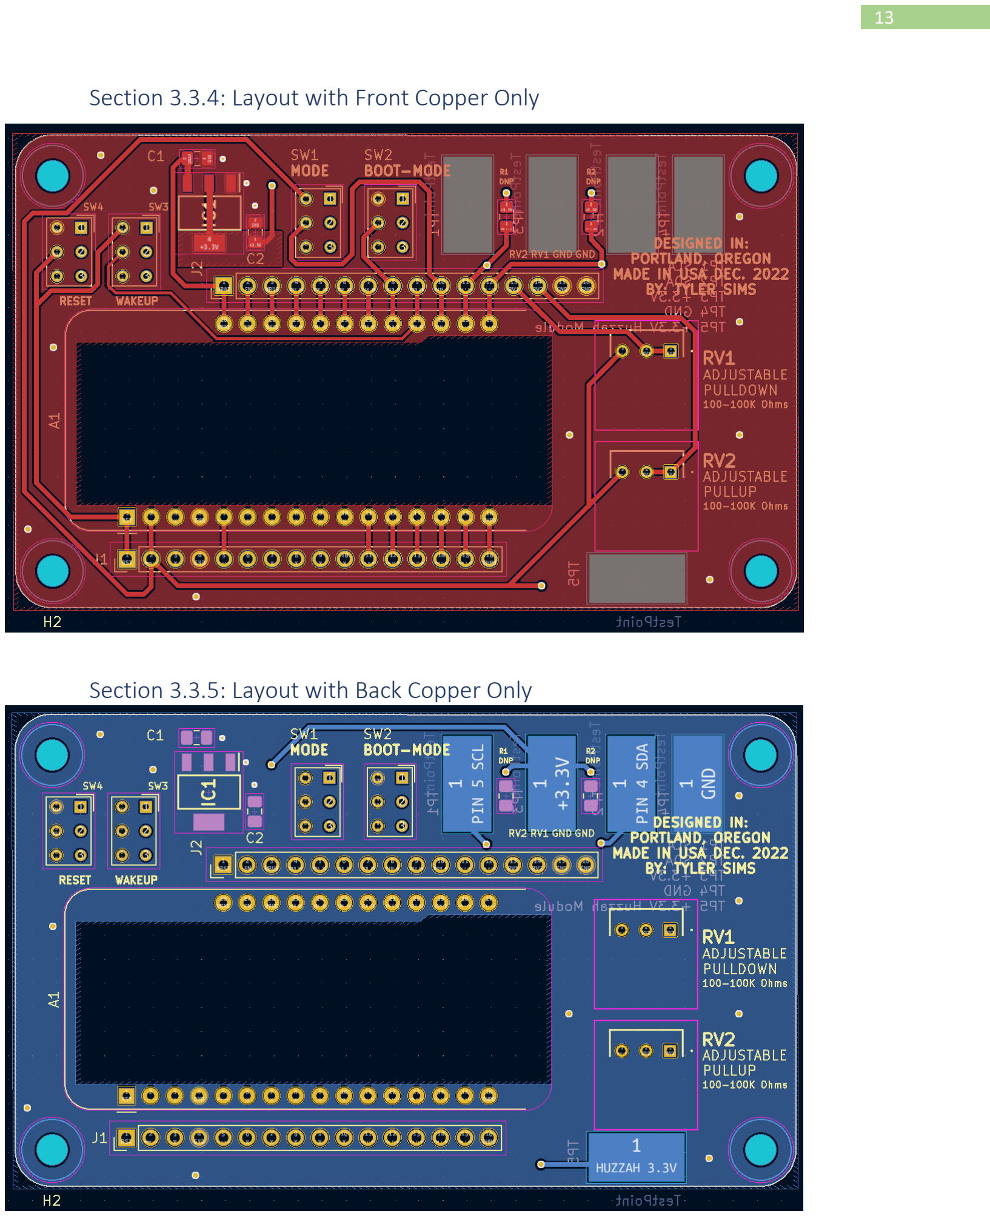
[picture p30: page 13]

Section 3.3.4: Layout with Front Copper Only

Section 3.3.5: Layout with Back Copper Only

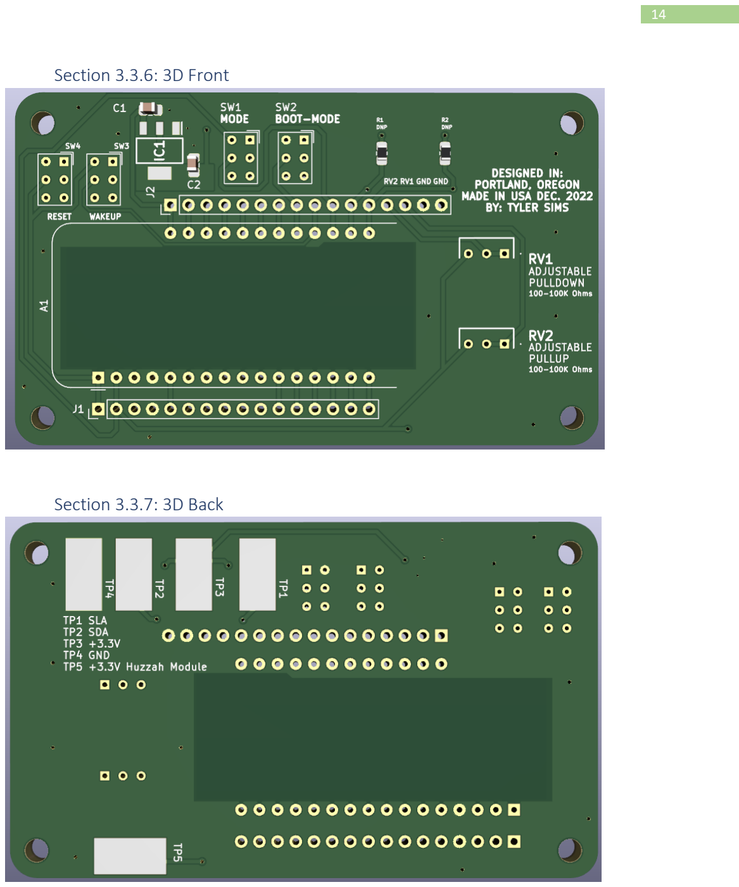
[picture p31: page 14]

Section 3.3.6: 3D Front

Section 3.3.7: 3D Back

### Section 3.4: Aluminum Top

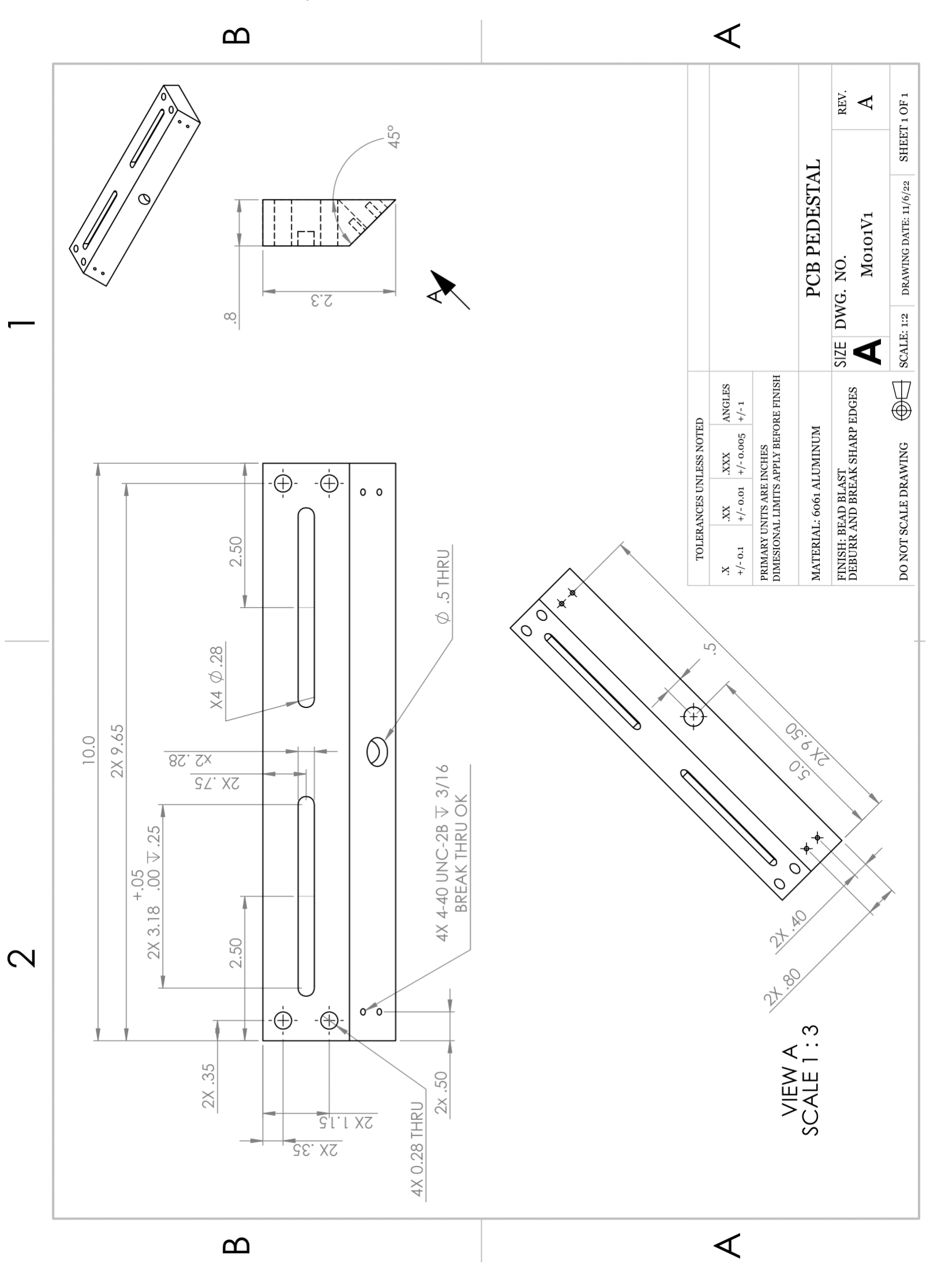
[picture p32: figure]
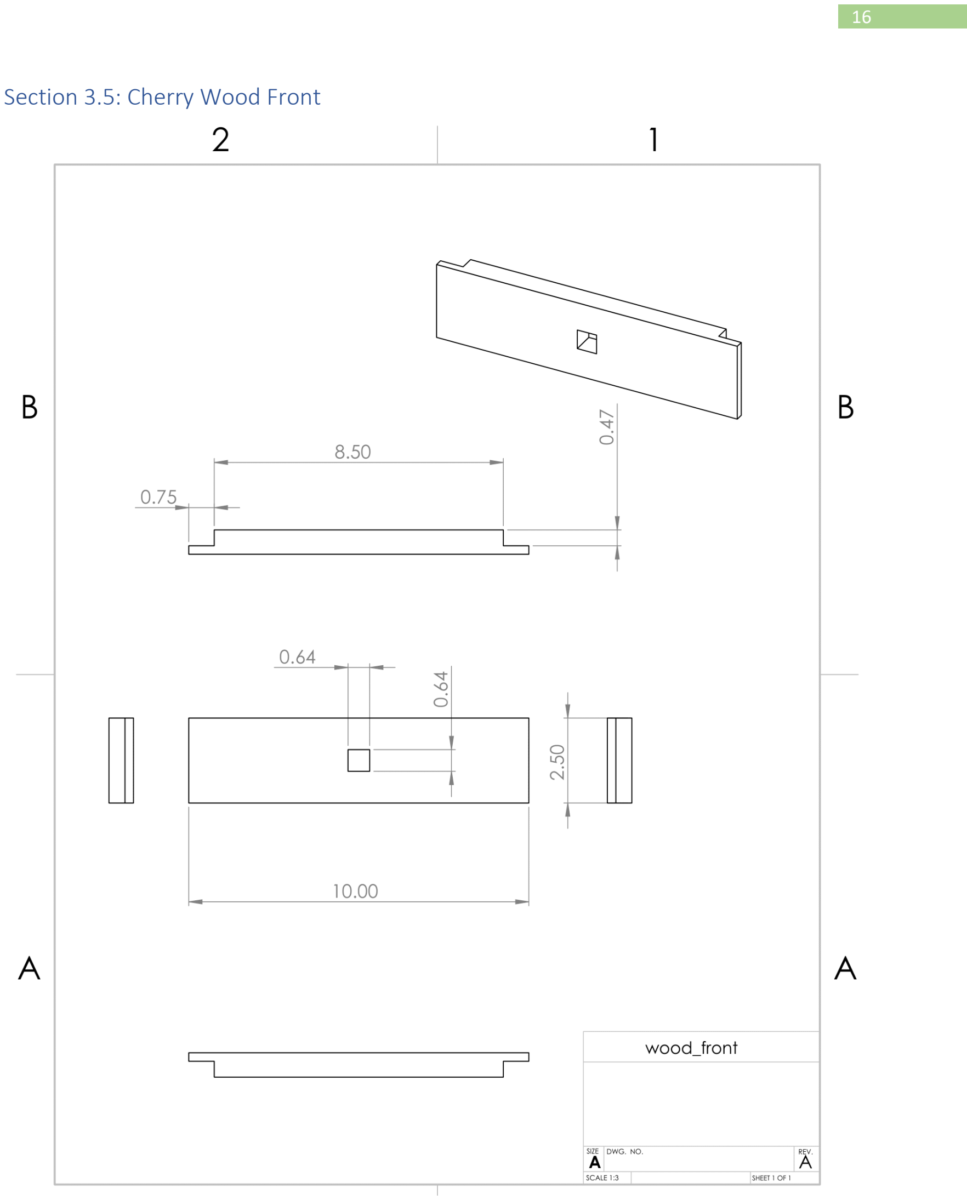
[picture p33: page 16]

Section 3.5: Cherry Wood Front

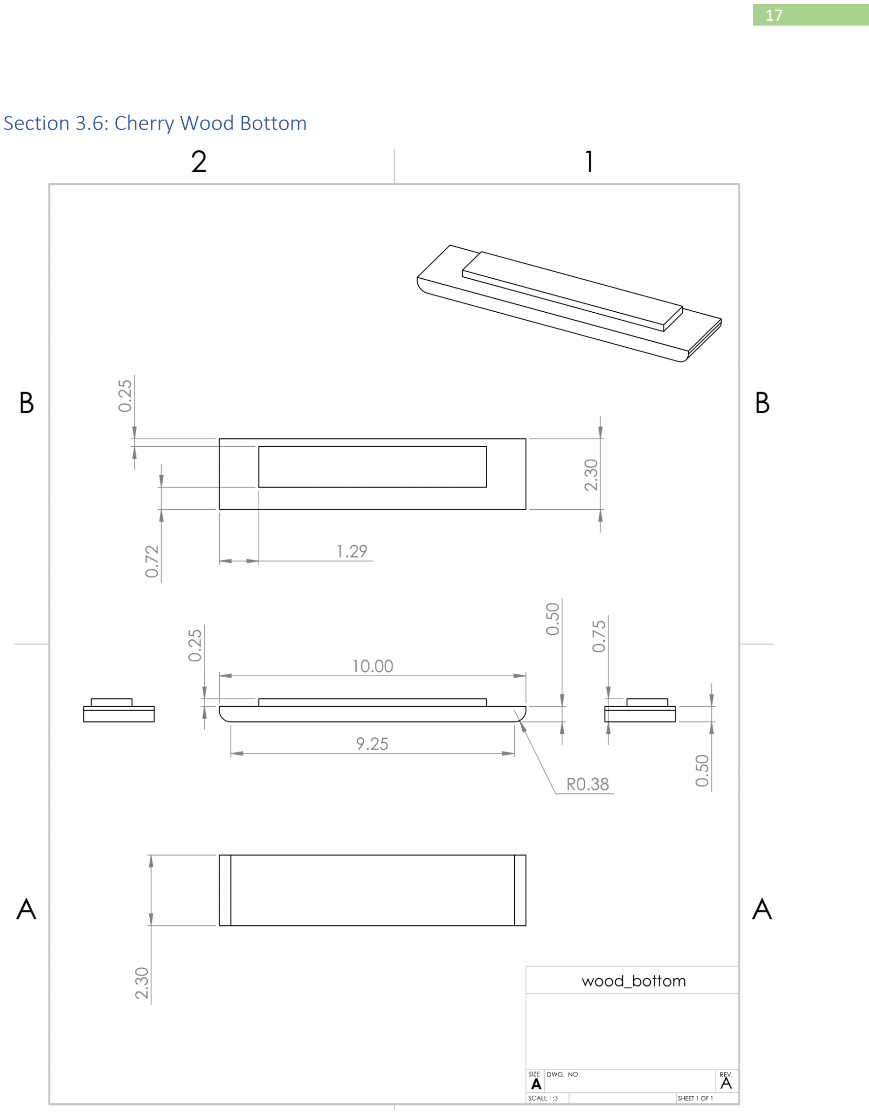
[picture p34: page 17]

Section 3.6: Cherry Wood Bottom

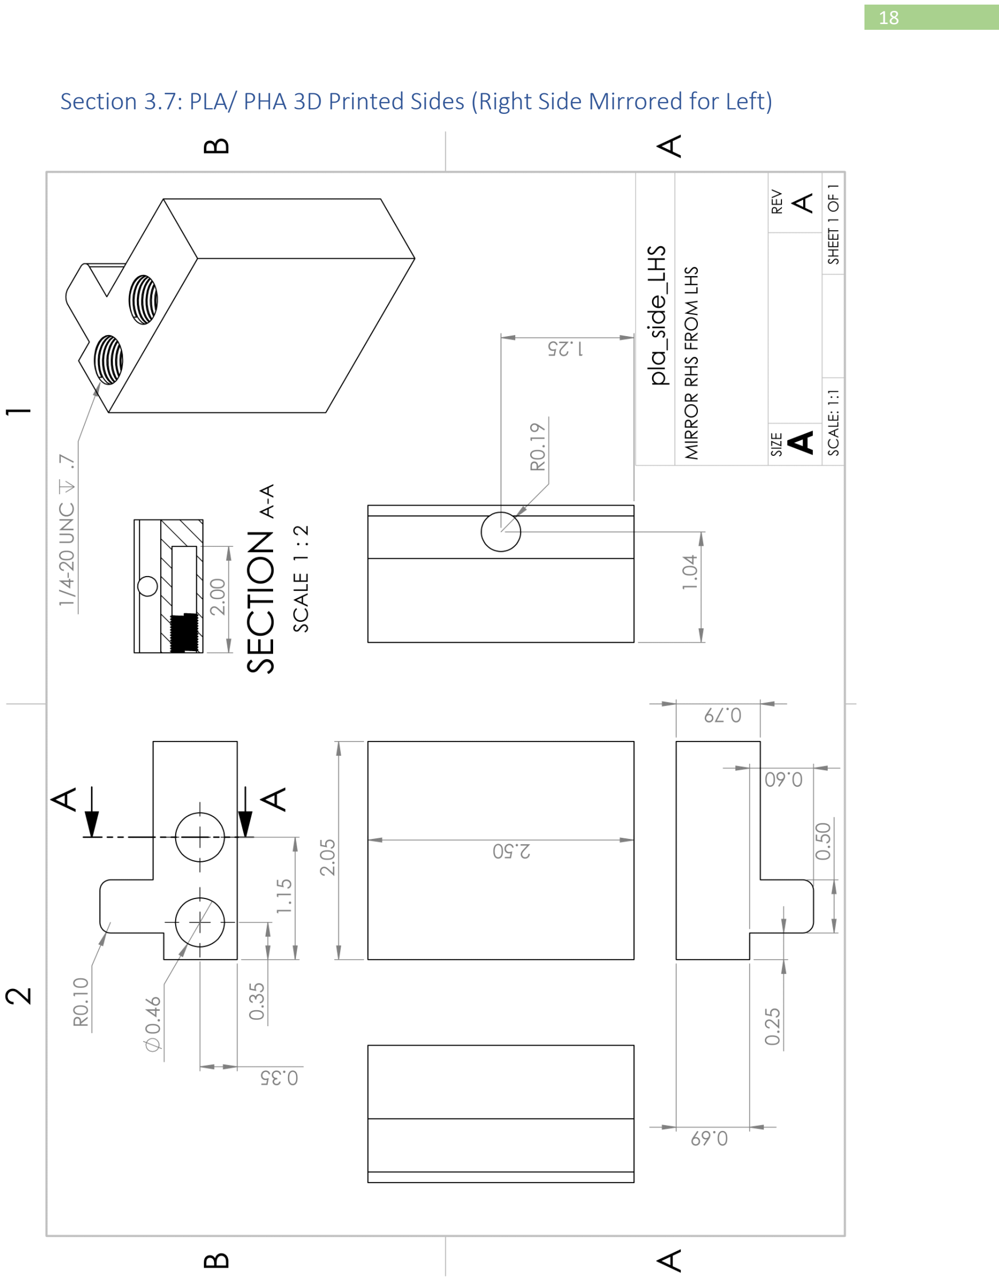
[picture p35: page 18]

Section 3.7: PLA/ PHA 3D Printed Sides (Right Side Mirrored for Left)

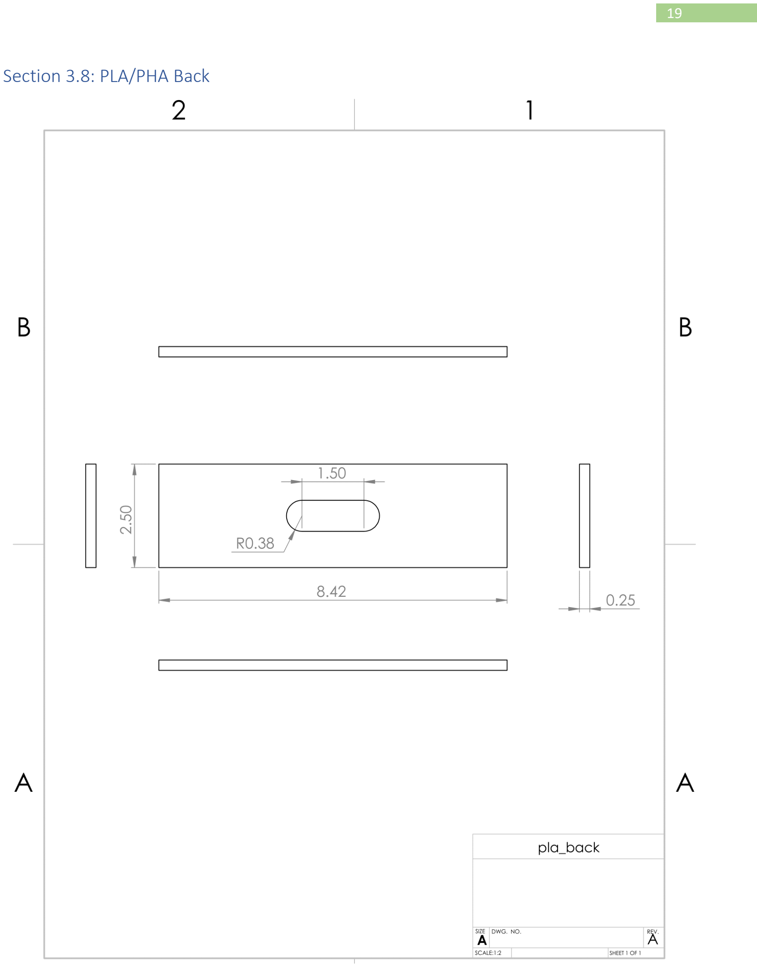
[picture p36: page 19]

Section 3.

8: PLA/PHA Back

## Section 4: Bill of Materials (BOM)

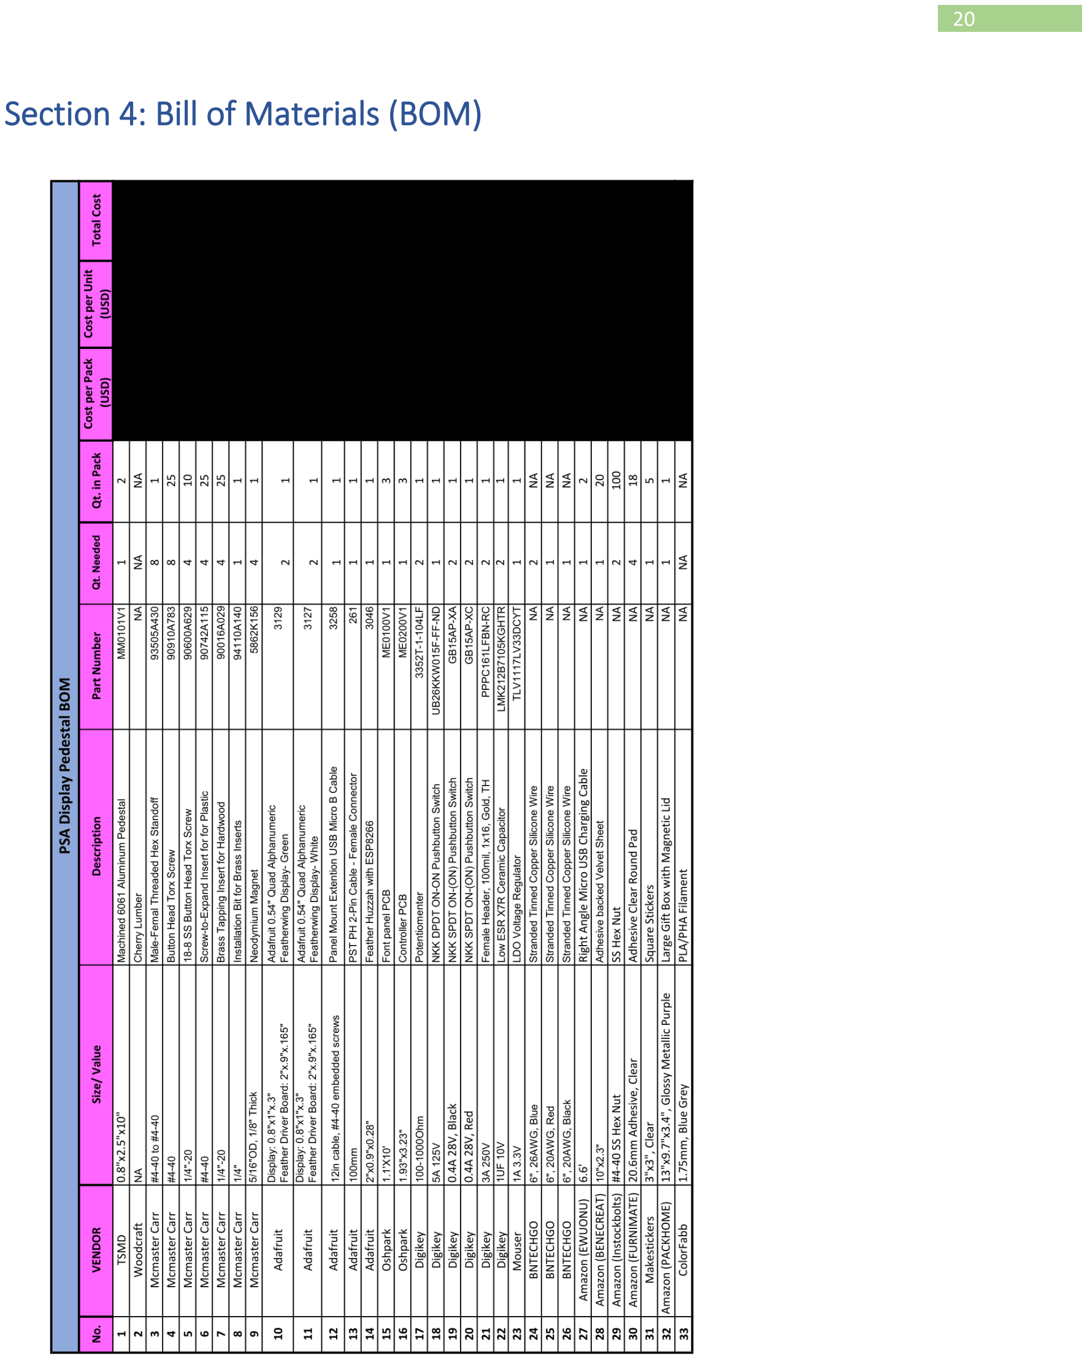
[picture p37: page 20]
