tylerssims/psa_display_pedestal/psa_display_pedestal/images/pedestal_assembly.png

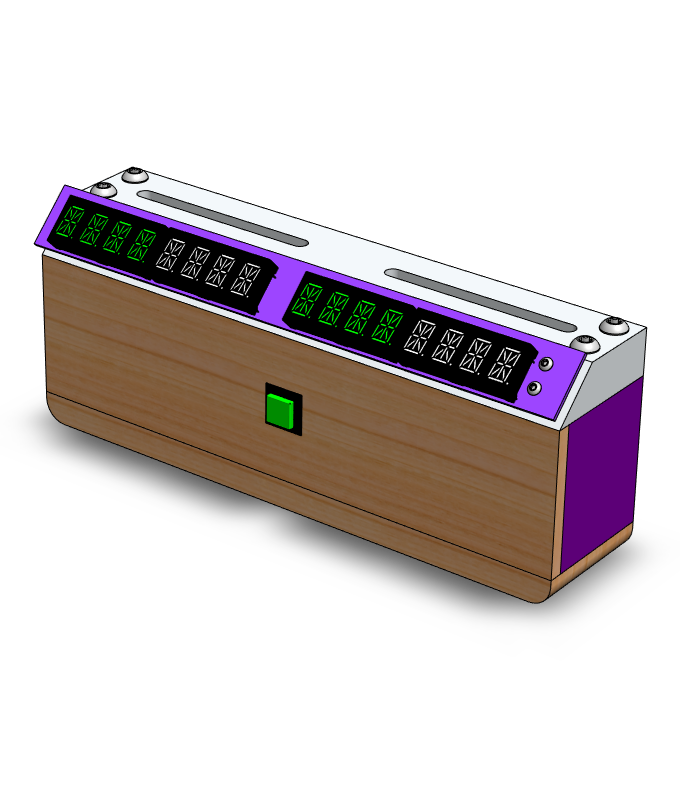
psa_display_pedestal/images/pedestal_assembly.png
