tylerssims/psa_display_pedestal/psa_display_pedestal/printed_circuit_boards/front_panel_display_pcb/psa_display_pcb/images/Back Copper.png

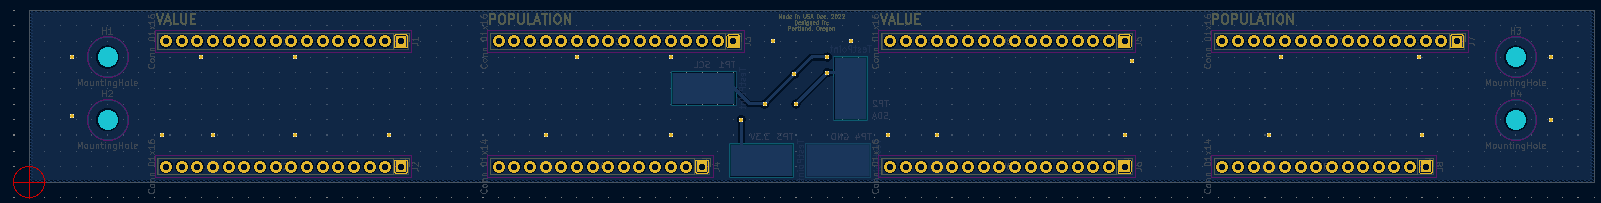
psa_display_pedestal/printed_circuit_boards/front_panel_display_pcb/psa_display_pcb/images/Back Copper.png
