tylerssims/psa_display_pedestal/psa_display_pedestal/printed_circuit_boards/front_panel_display_pcb/psa_display_pcb/images/Both Planes Visible.png

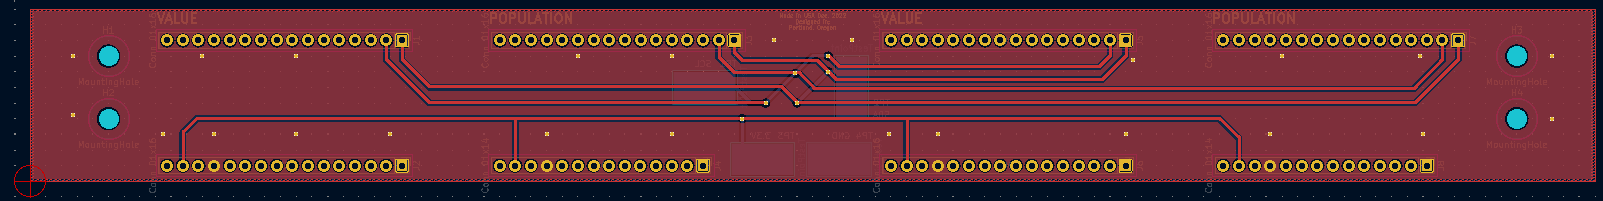
psa_display_pedestal/printed_circuit_boards/front_panel_display_pcb/psa_display_pcb/images/Both Planes Visible.png
