tylerssims/psa_display_pedestal/psa_display_pedestal/printed_circuit_boards/huzzah_control_pcb/huzzah_breakout_pcb/images/Layout with Front Copper.png

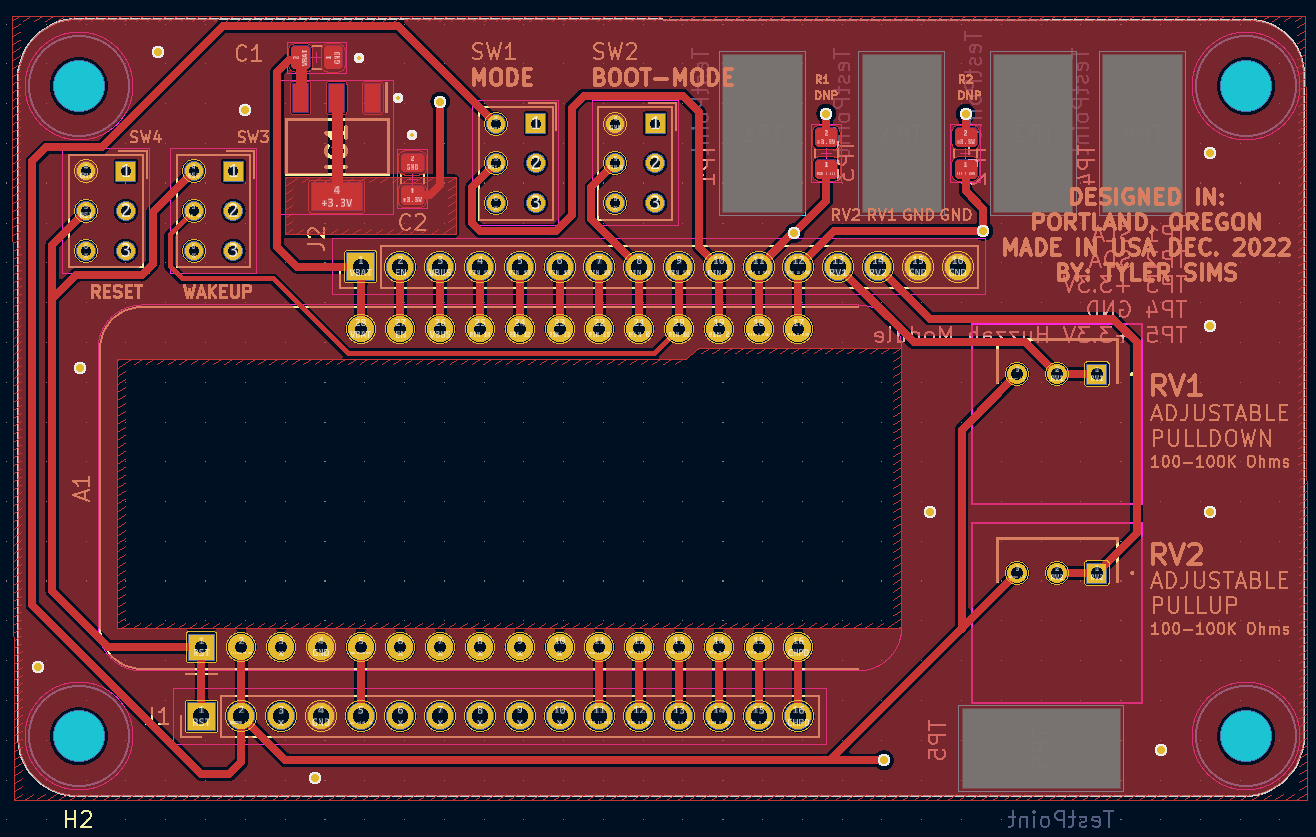
psa_display_pedestal/printed_circuit_boards/huzzah_control_pcb/huzzah_breakout_pcb/images/Layout with Front Copper.png
