tylerssims/psa_display_pedestal/psa_display_pedestal/drawings/.PDF/pedestal_assembly.pdf

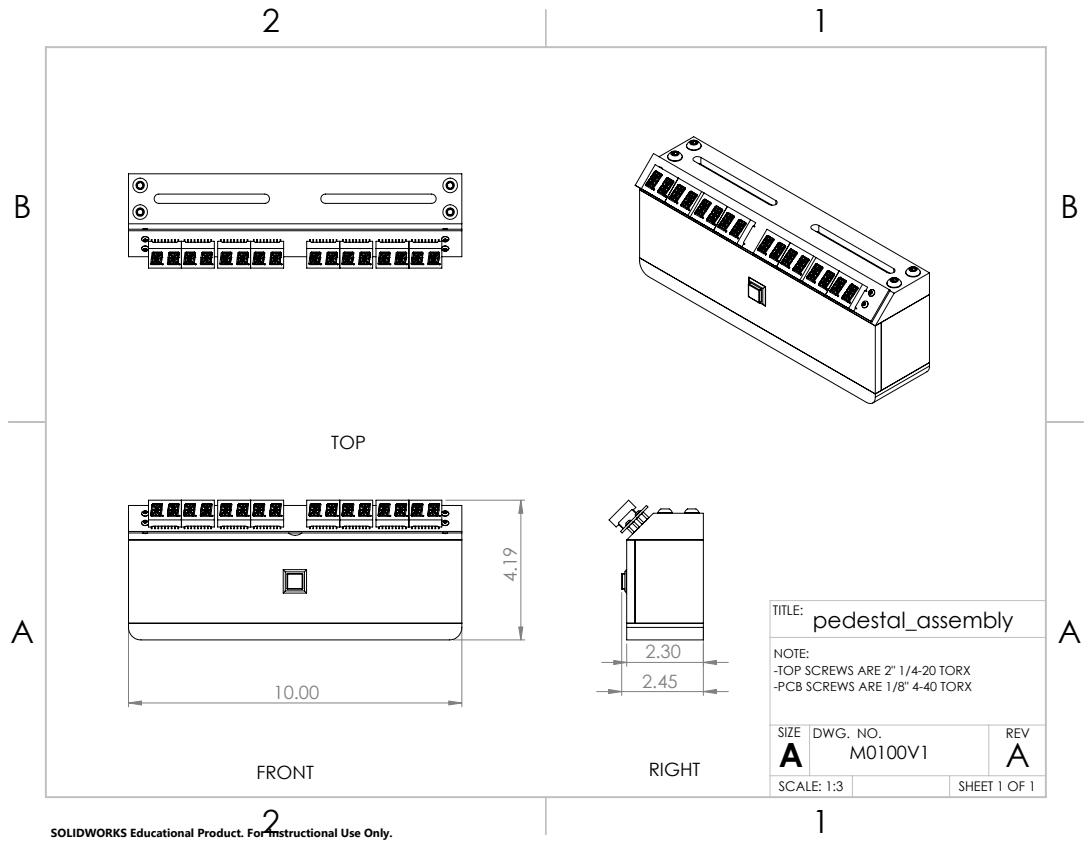
[picture p49: page 1]

NOTE:
-TOP SCREWS ARE 2" 1/4-20 TORX
-PCB SCREWS ARE 1/8" 4-40 TORX

SIZE A | DWG. NO. M0100V1 | REV A

SCALE: 1:3 | | SHEET 1 OF 1

SOLIDWORKS Educational Product. For Instructional Use Only.
