tylerssims/psa_display_pedestal/psa_display_pedestal/drawings/.PDF/0.25-20_button_head_torx_screw.PDF

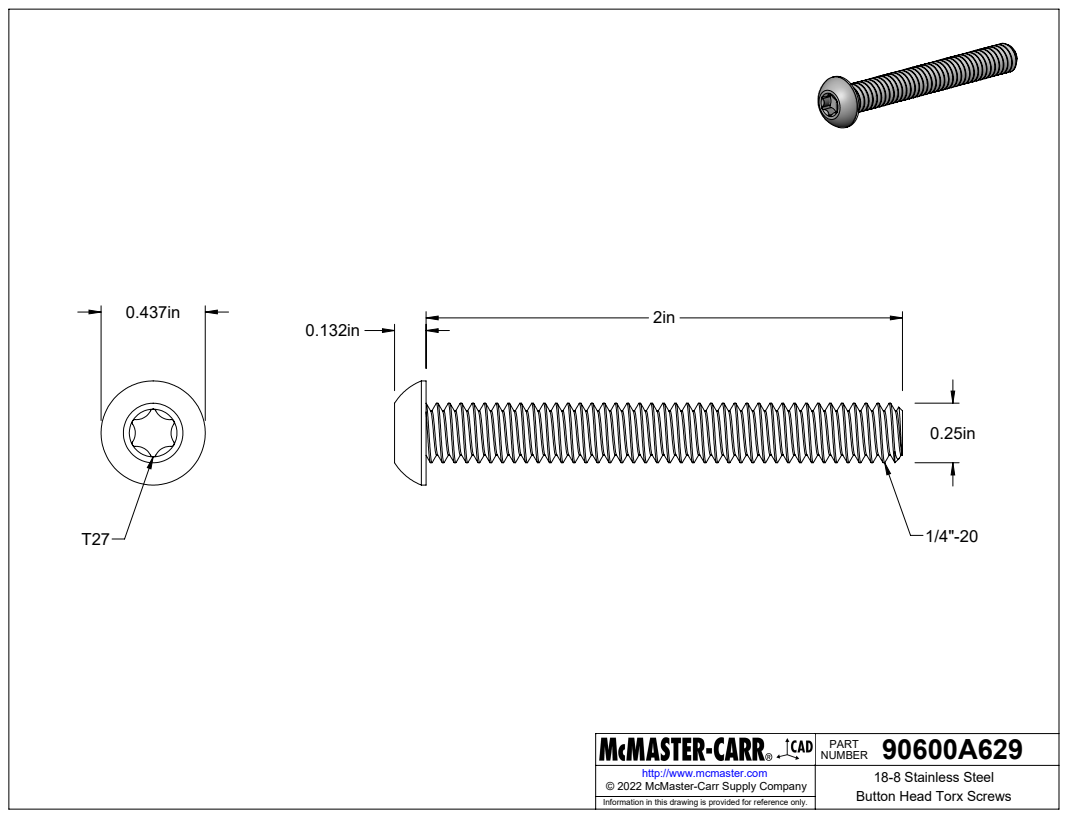
[picture p50: page 1]

90600A629 PART NUMBER

http://www.mcmaster.com | 18-8 Stainless Steel Button Head Torx Screws © 2022 McMaster-Carr Supply Company

Information in this drawing is provided for reference only.
