tylerssims/psa_display_pedestal/psa_display_pedestal/drawings/.PDF/4-40_button_head_torx_screw.PDF

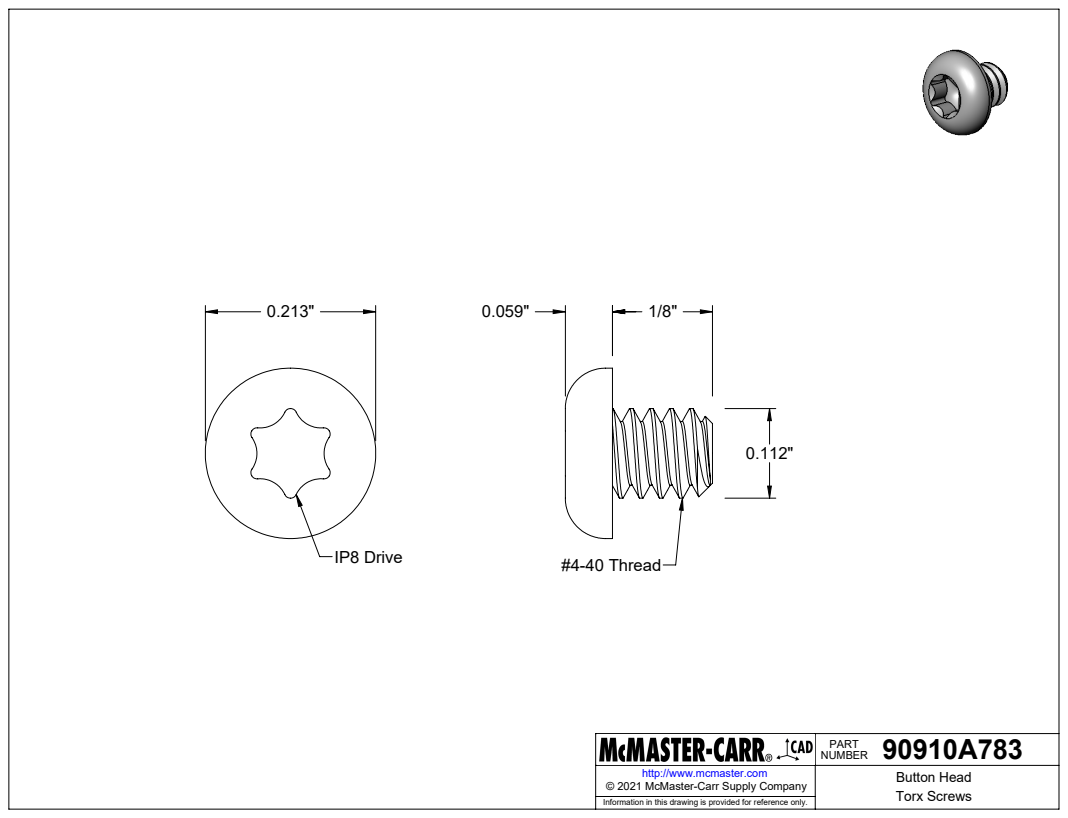
[picture p51: page 1]
IP8 Drive; #4-40 Thread

90910A783 PART NUMBER

http://www.mcmaster.com | Button Head Torx Screws © 2021 McMaster-Carr Supply Company

Information in this drawing is provided for reference only.
