tylerssims/psa_display_pedestal/psa_display_pedestal/drawings/.PDF/4-40_threaded_hex_standoff.PDF

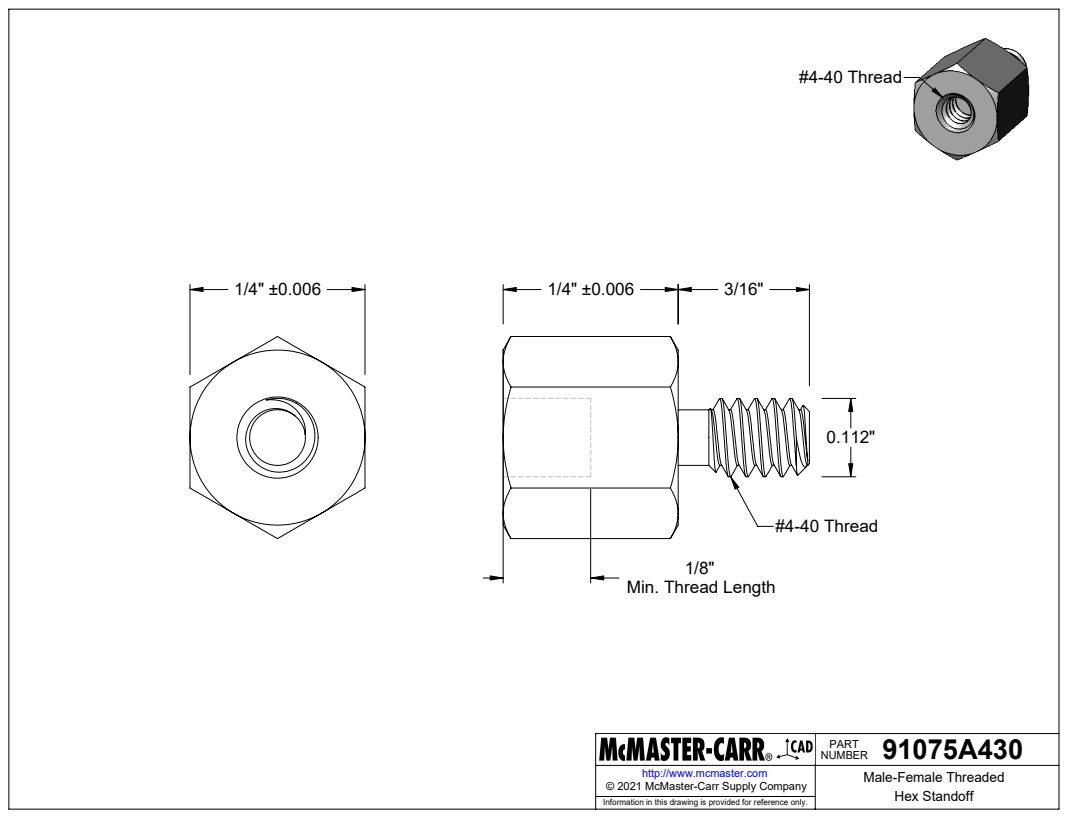
[picture p52: page 1]
#4-40 Thread

Min. Thread Length

91075A430 PART NUMBER

http://www.mcmaster.com | Male-Female Threaded Hex Standoff © 2021 McMaster-Carr Supply Company

Information in this drawing is provided for reference only.
