tylerssims/psa_display_pedestal/psa_display_pedestal/drawings/.PDF/Aluminum Screw-to-Expand Insert for Plastic.PDF

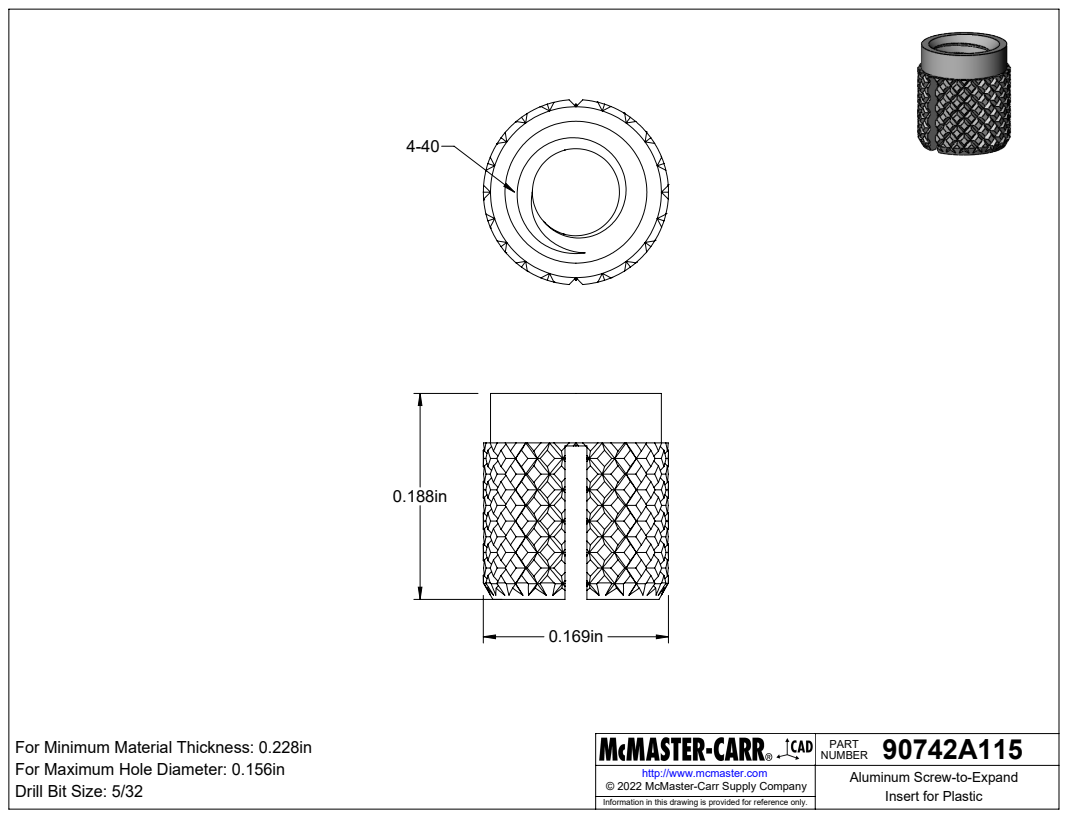
[picture p53: page 1]
Drill Bit Size: 5/32; Insert for Plastic © 2022 McMaster-Carr Supply Company

90742A115 PART NUMBER

For Minimum Material Thickness: 0.228in
For Maximum Hole Diameter: 0.156in

http://www.mcmaster.com | Aluminum Screw-to-Expand

Information in this drawing is provided for reference only.
