tylerssims/psa_display_pedestal/psa_display_pedestal/drawings/.PDF/aluminum_pedestal_REVA.pdf

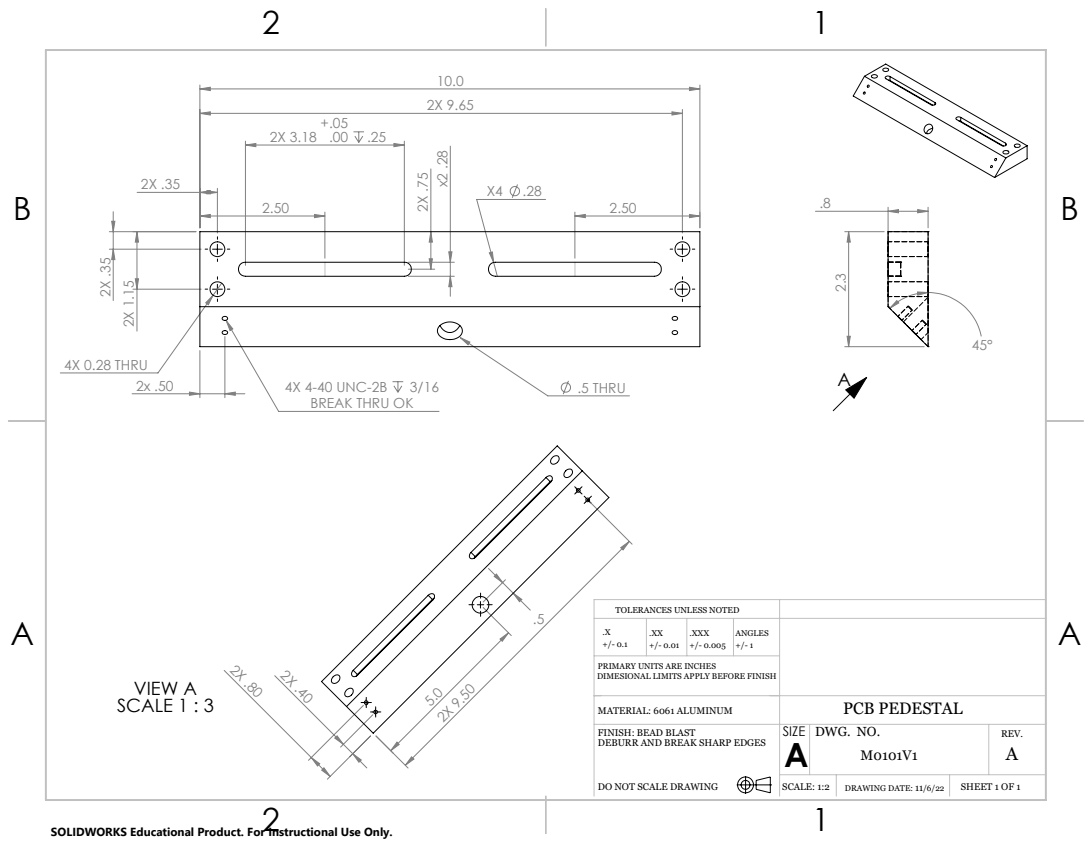
[picture p54: page 1]
4X 0.28 THRU; .5 THRU; VIEW A SCALE 1 : 3

4X 4-40 UNC-2B 3/16
BREAK THRU OK

TOLERANCES UNLESS NOTED

.X +/- 0.1 | .XX +/- 0.01 | .XXX +/- 0.005 | ANGLES +/- 1

PRIMARY UNITS ARE INCHES
DIMESIONAL LIMITS APPLY BEFORE FINISH

MATERIAL: 6061 ALUMINUM | PCB PEDESTAL

FINISH: BEAD BLAST DEBURR AND BREAK SHARP EDGES DO NOT SCALE DRAWING | SIZE A | DWG. NO. M0101V1 | REV. A

SCALE: 1:2 | DRAWING DATE: 11/6/22 | SHEET 1 OF 1

SOLIDWORKS Educational Product. For Instructional Use Only.
