tylerssims/psa_display_pedestal/psa_display_pedestal/drawings/.PDF/neodymium_magnet.PDF

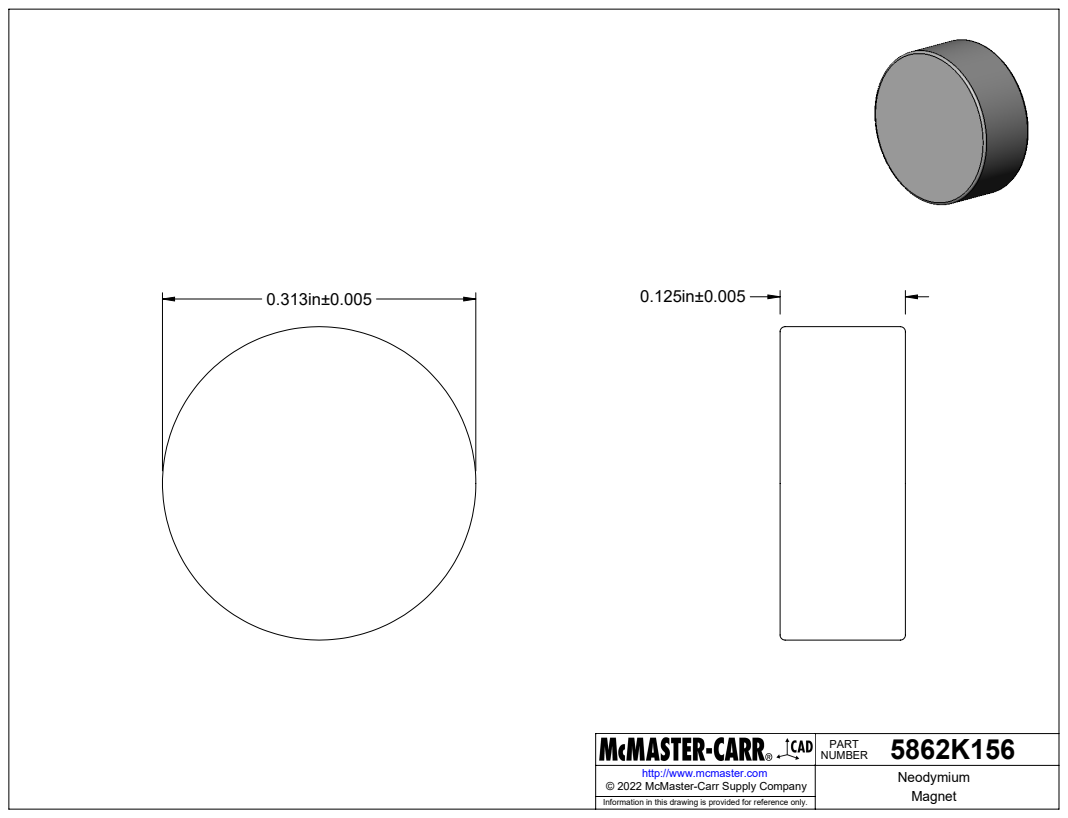
[picture p55: page 1]

5862K156 PART NUMBER

http://www.mcmaster.com | Neodymium Magnet © 2022 McMaster-Carr Supply Company

Information in this drawing is provided for reference only.
