tylerssims/psa_display_pedestal/psa_display_pedestal/drawings/.PDF/threaded_brass_tapping_insert.PDF

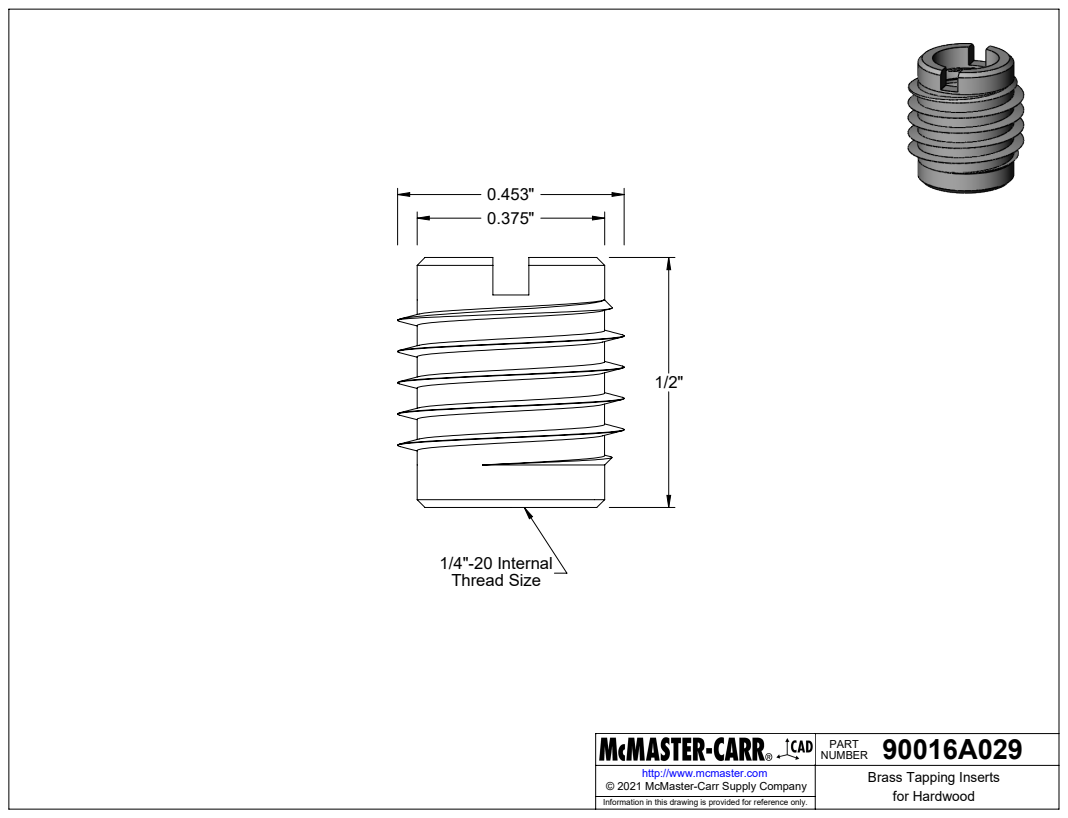
[picture p56: page 1]
1/4"-20 Internal Thread Size

90016A029 PART NUMBER

http://www.mcmaster.com | Brass Tapping Inserts for Hardwood © 2021 McMaster-Carr Supply Company

Information in this drawing is provided for reference only.
