tylerssims/psa_display_pedestal/psa_display_pedestal/drawings/.PDF/front_panel_pcb_schematic_bw.pdf

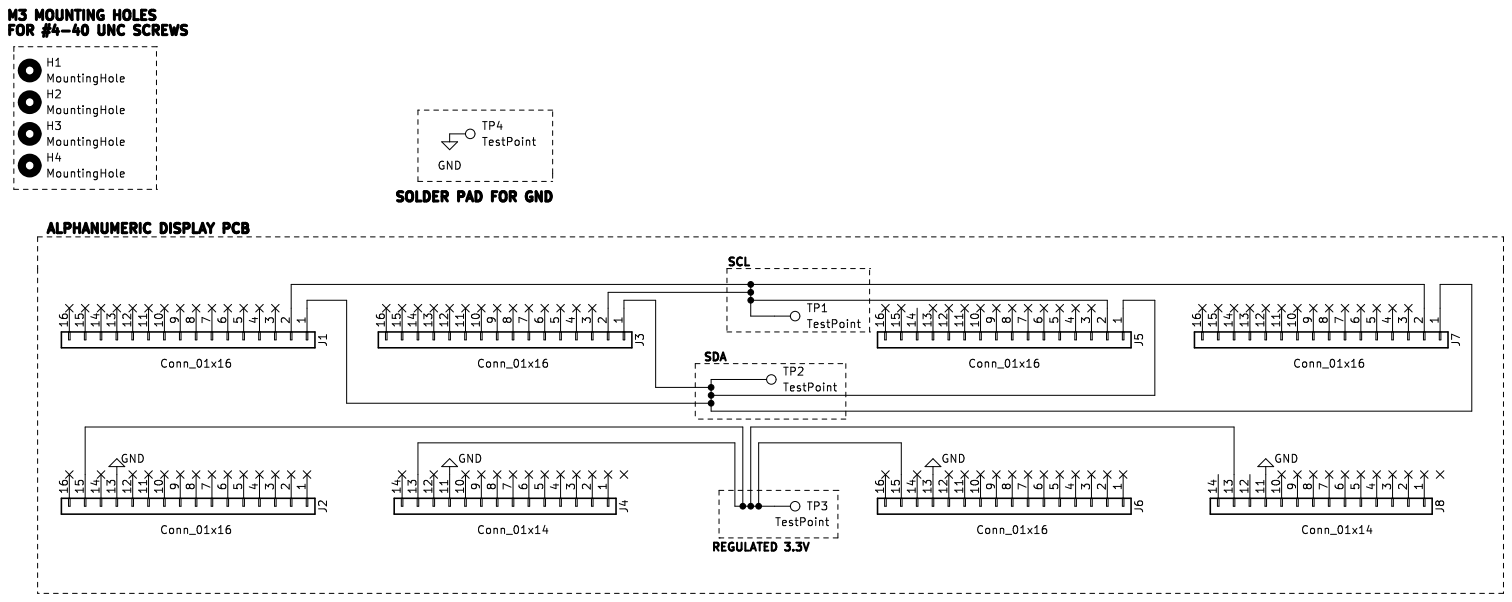
[picture p57: page 1]
