tylerssims/psa_display_pedestal/psa_display_pedestal/drawings/.PDF/front_panel_pcb_schematic_color.pdf

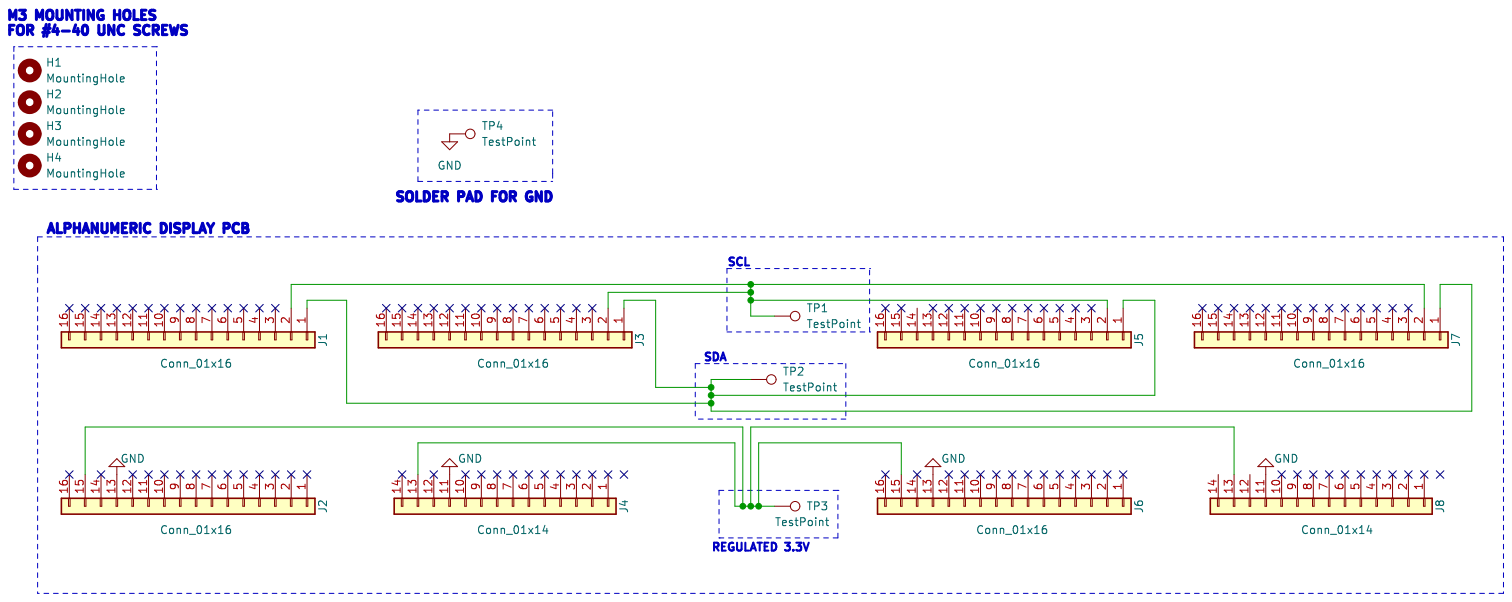
[picture p58: page 1]
