tylerssims/psa_display_pedestal/psa_display_pedestal/printed_circuit_boards/huzzah_control_pcb/huzzah_breakout_pcb/pdf/PSA SCH.pdf

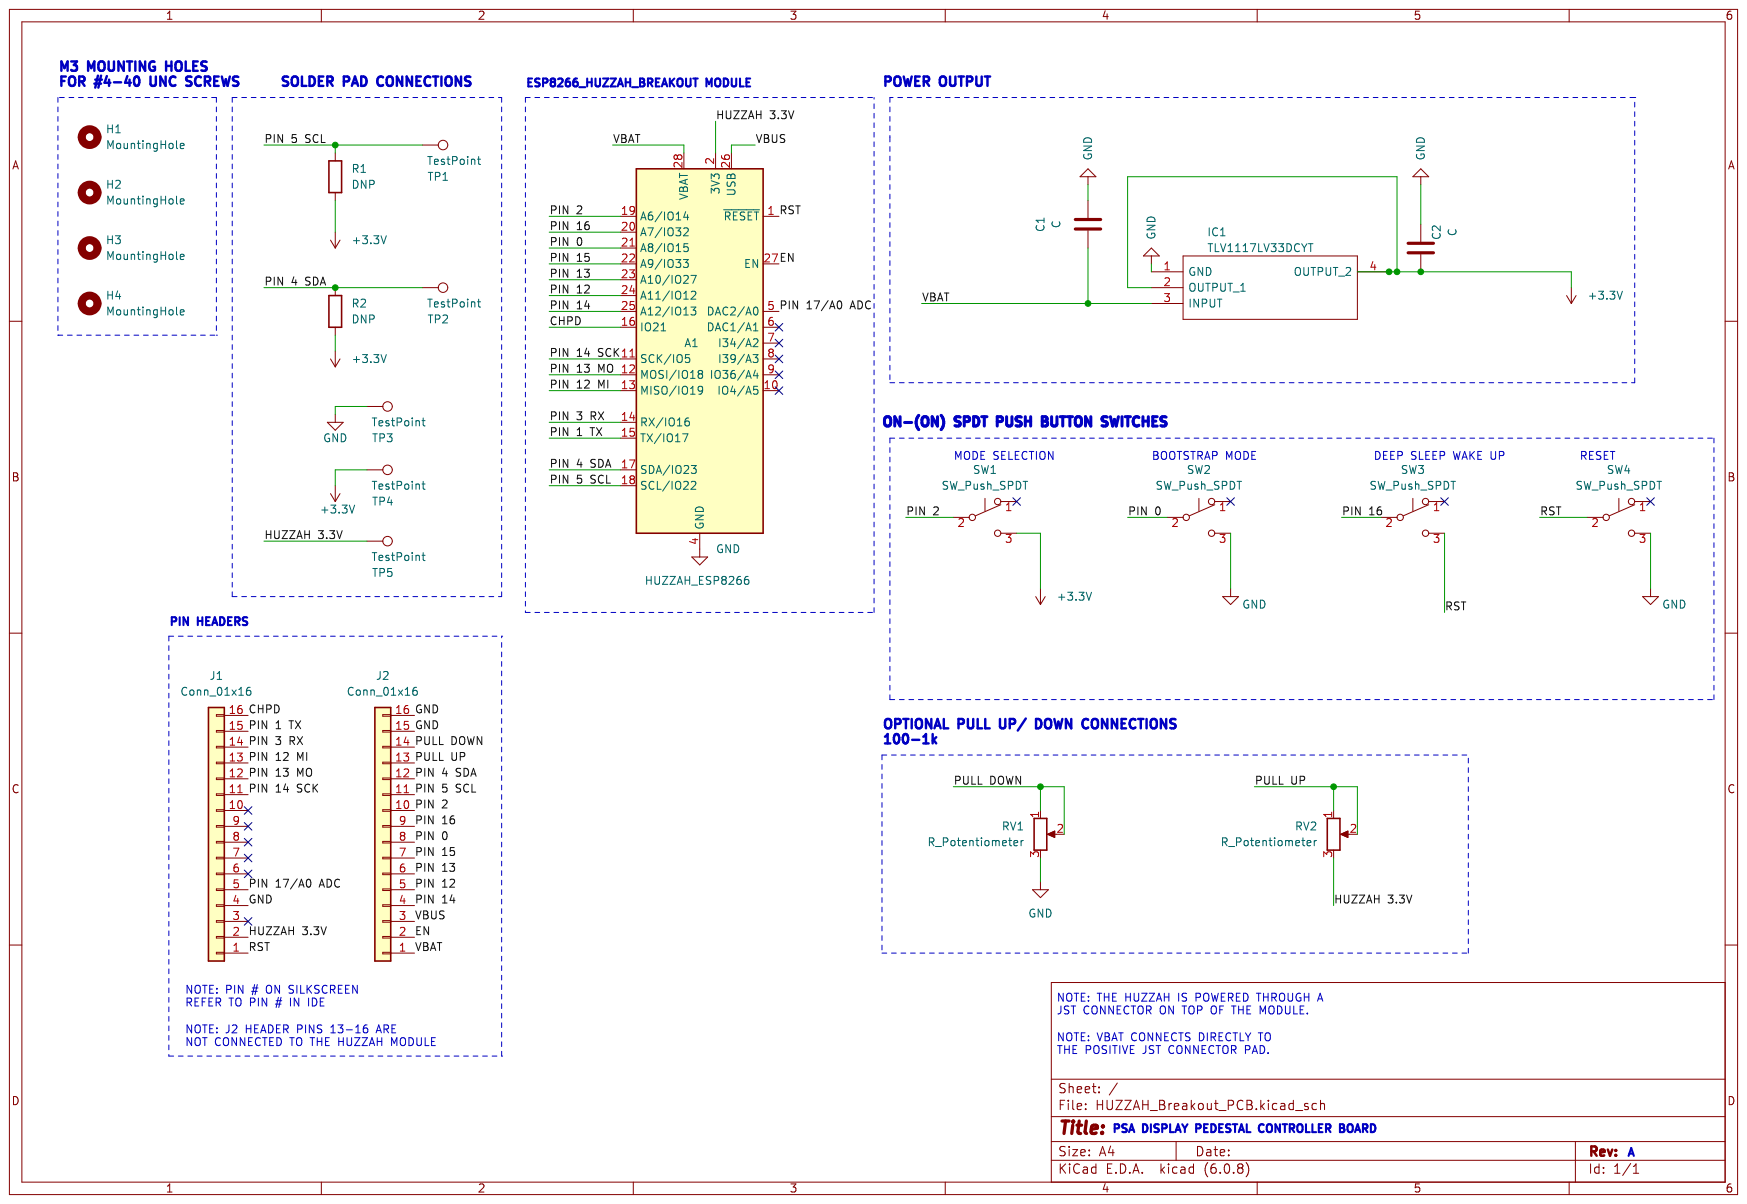
[picture p59: page 1]
