tylerssims/psa_display_pedestal/psa_display_pedestal/drawings/.PDF/huzzah_control_pcb_bw.pdf

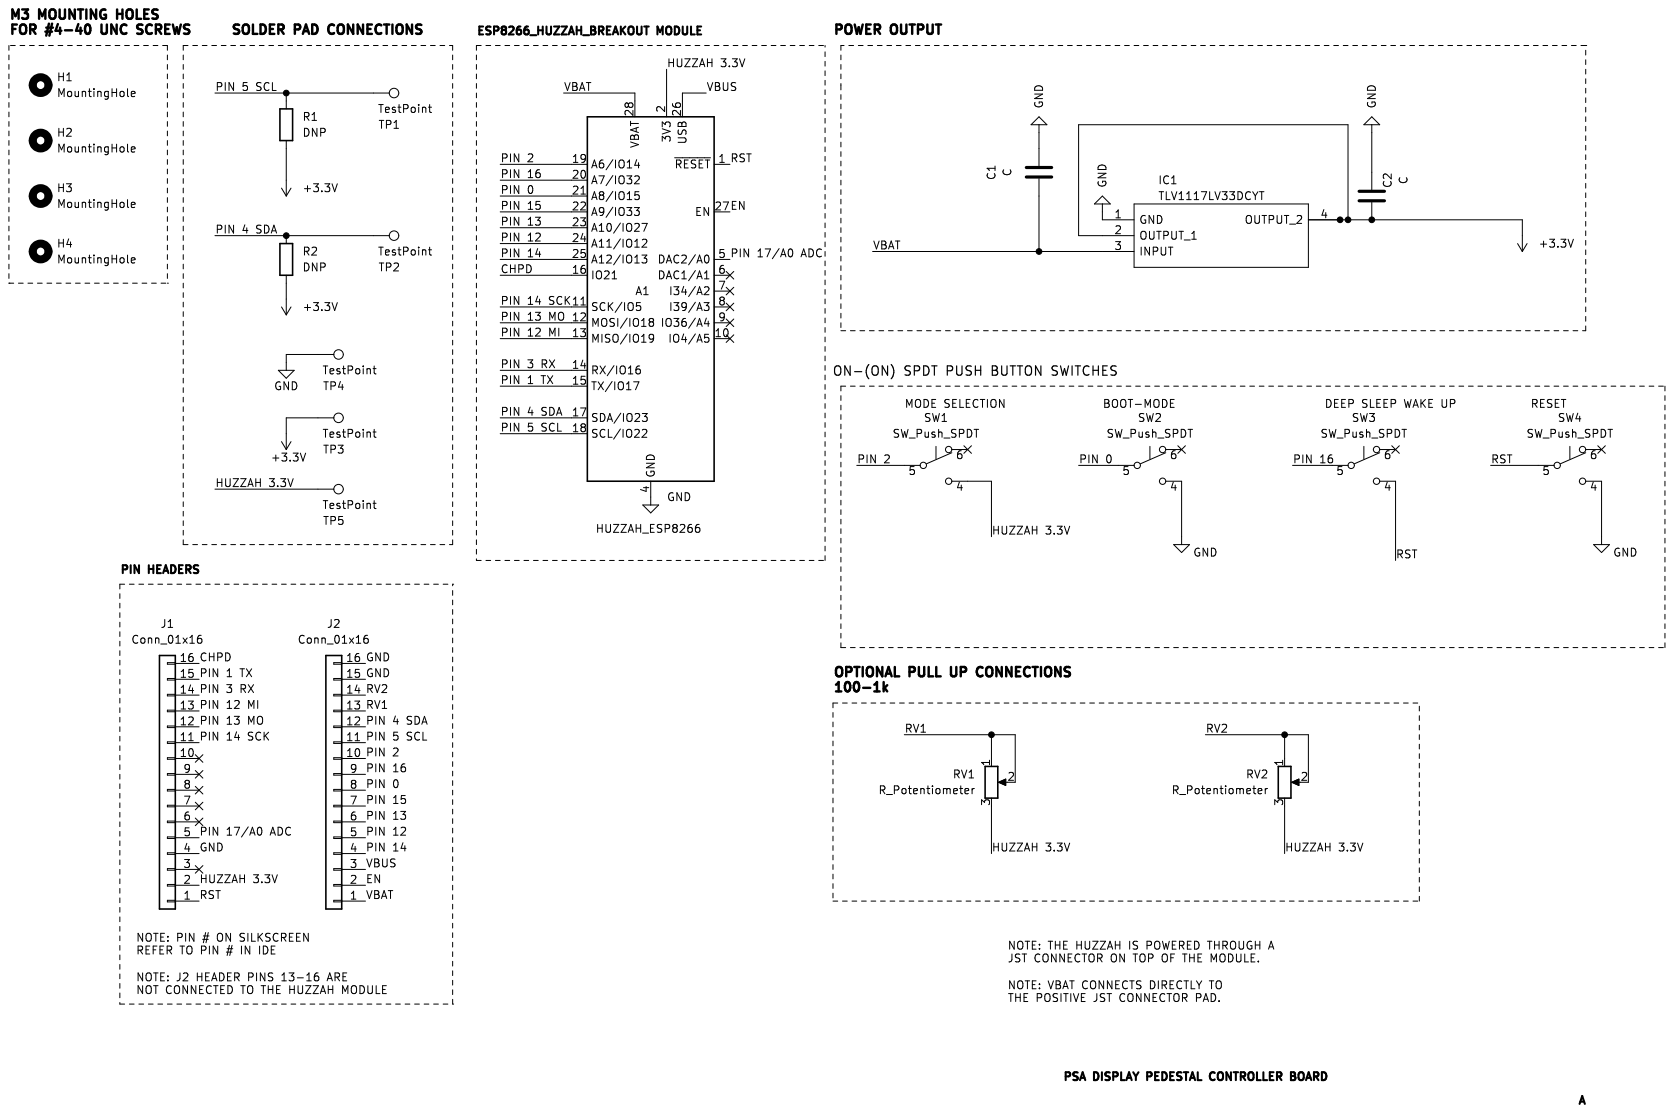
[picture p60: page 1]
