tylerssims/psa_display_pedestal/psa_display_pedestal/drawings/.PDF/huzzah_control_pcb_color.pdf

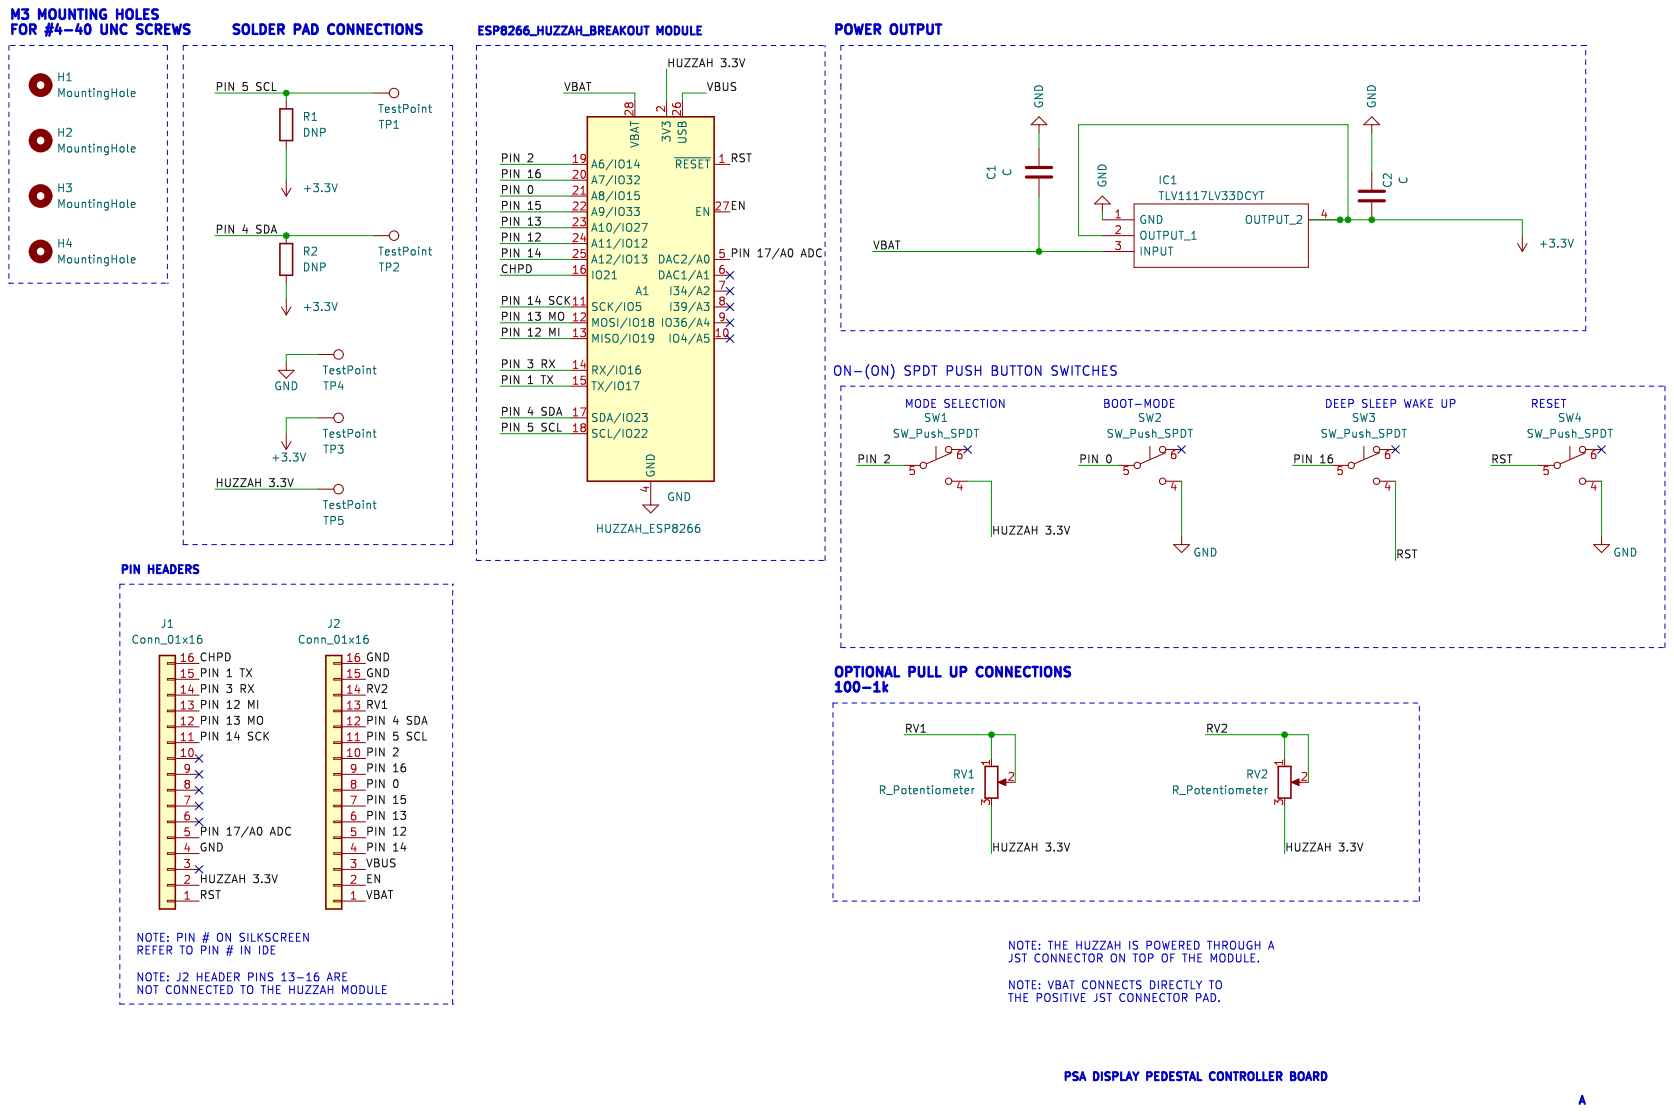
[picture p61: page 1]
