tylerssims/psa_display_pedestal/psa_display_pedestal/drawings/.PDF/pla_back.pdf

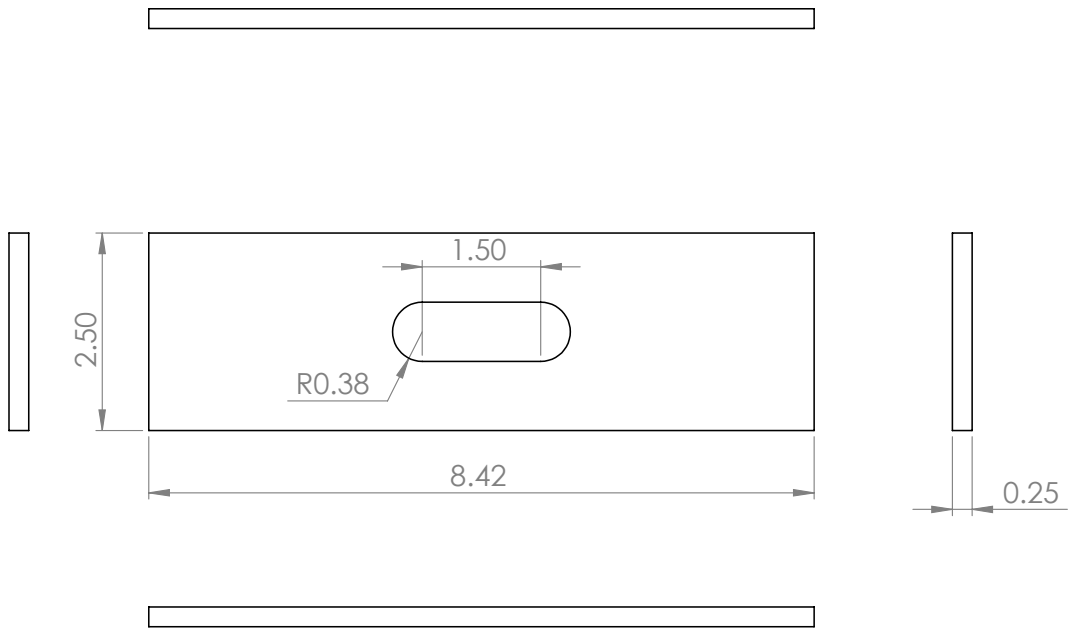
[picture p62: page 1]

SIZE A | DWG. NO. | REV. A

SCALE:1:2 | | SHEET 1 OF 1

SOLIDWORKS Educational Product. For Instructional Use Only.
