tylerssims/psa_display_pedestal/psa_display_pedestal/drawings/.PDF/pla_side_LHS.pdf

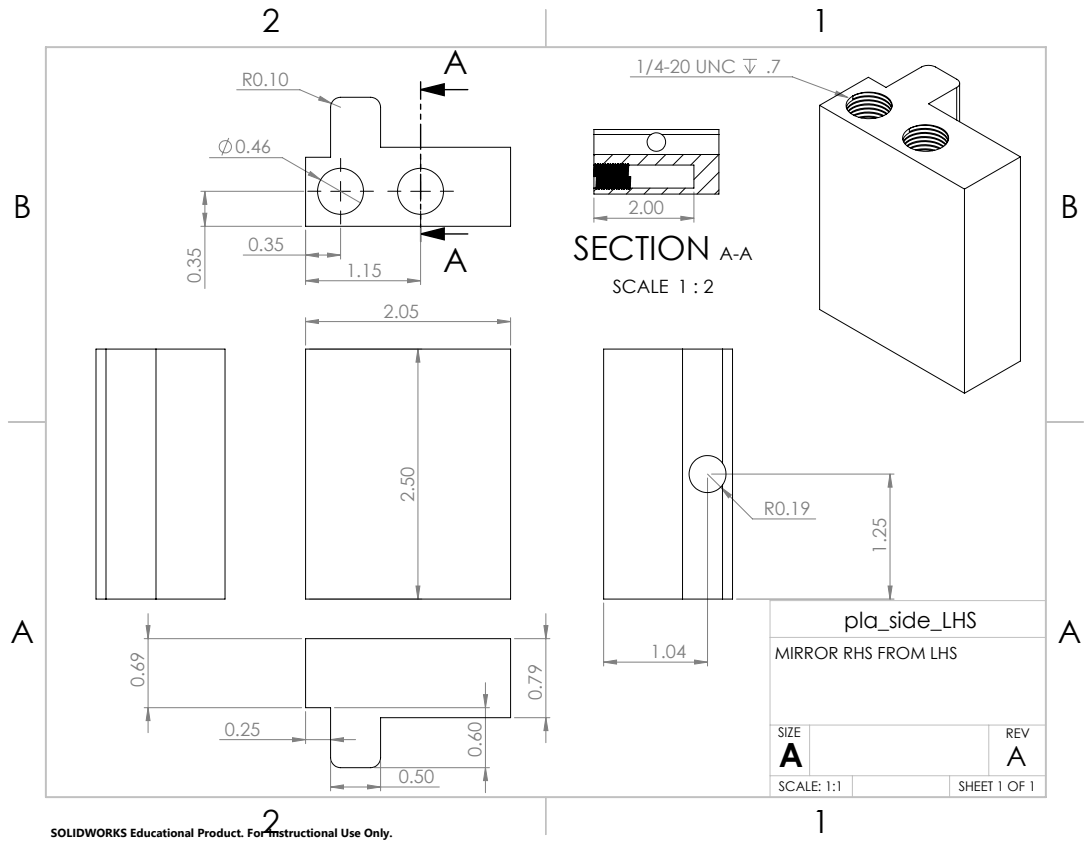
[picture p63: page 1]
1/4-20 UNC .7; SECTION A-A; SCALE 1 : 2

MIRROR RHS FROM LHS

SIZE A | REV A

SCALE: 1:1 | SHEET 1 OF 1

SOLIDWORKS Educational Product. For Instructional Use Only.
