tylerssims/psa_display_pedestal/psa_display_pedestal/printed_circuit_boards/huzzah_control_pcb/huzzah_breakout_pcb/HUZZAH_Breakout_PCB.kicad_pcb

## KiCad design psa_display_pedestal/printed_circuit_boards/huzzah_control_pcb/huzzah_breakout_pcb/HUZZAH_Breakout_PCB.kicad_pcb (2023-03-03)

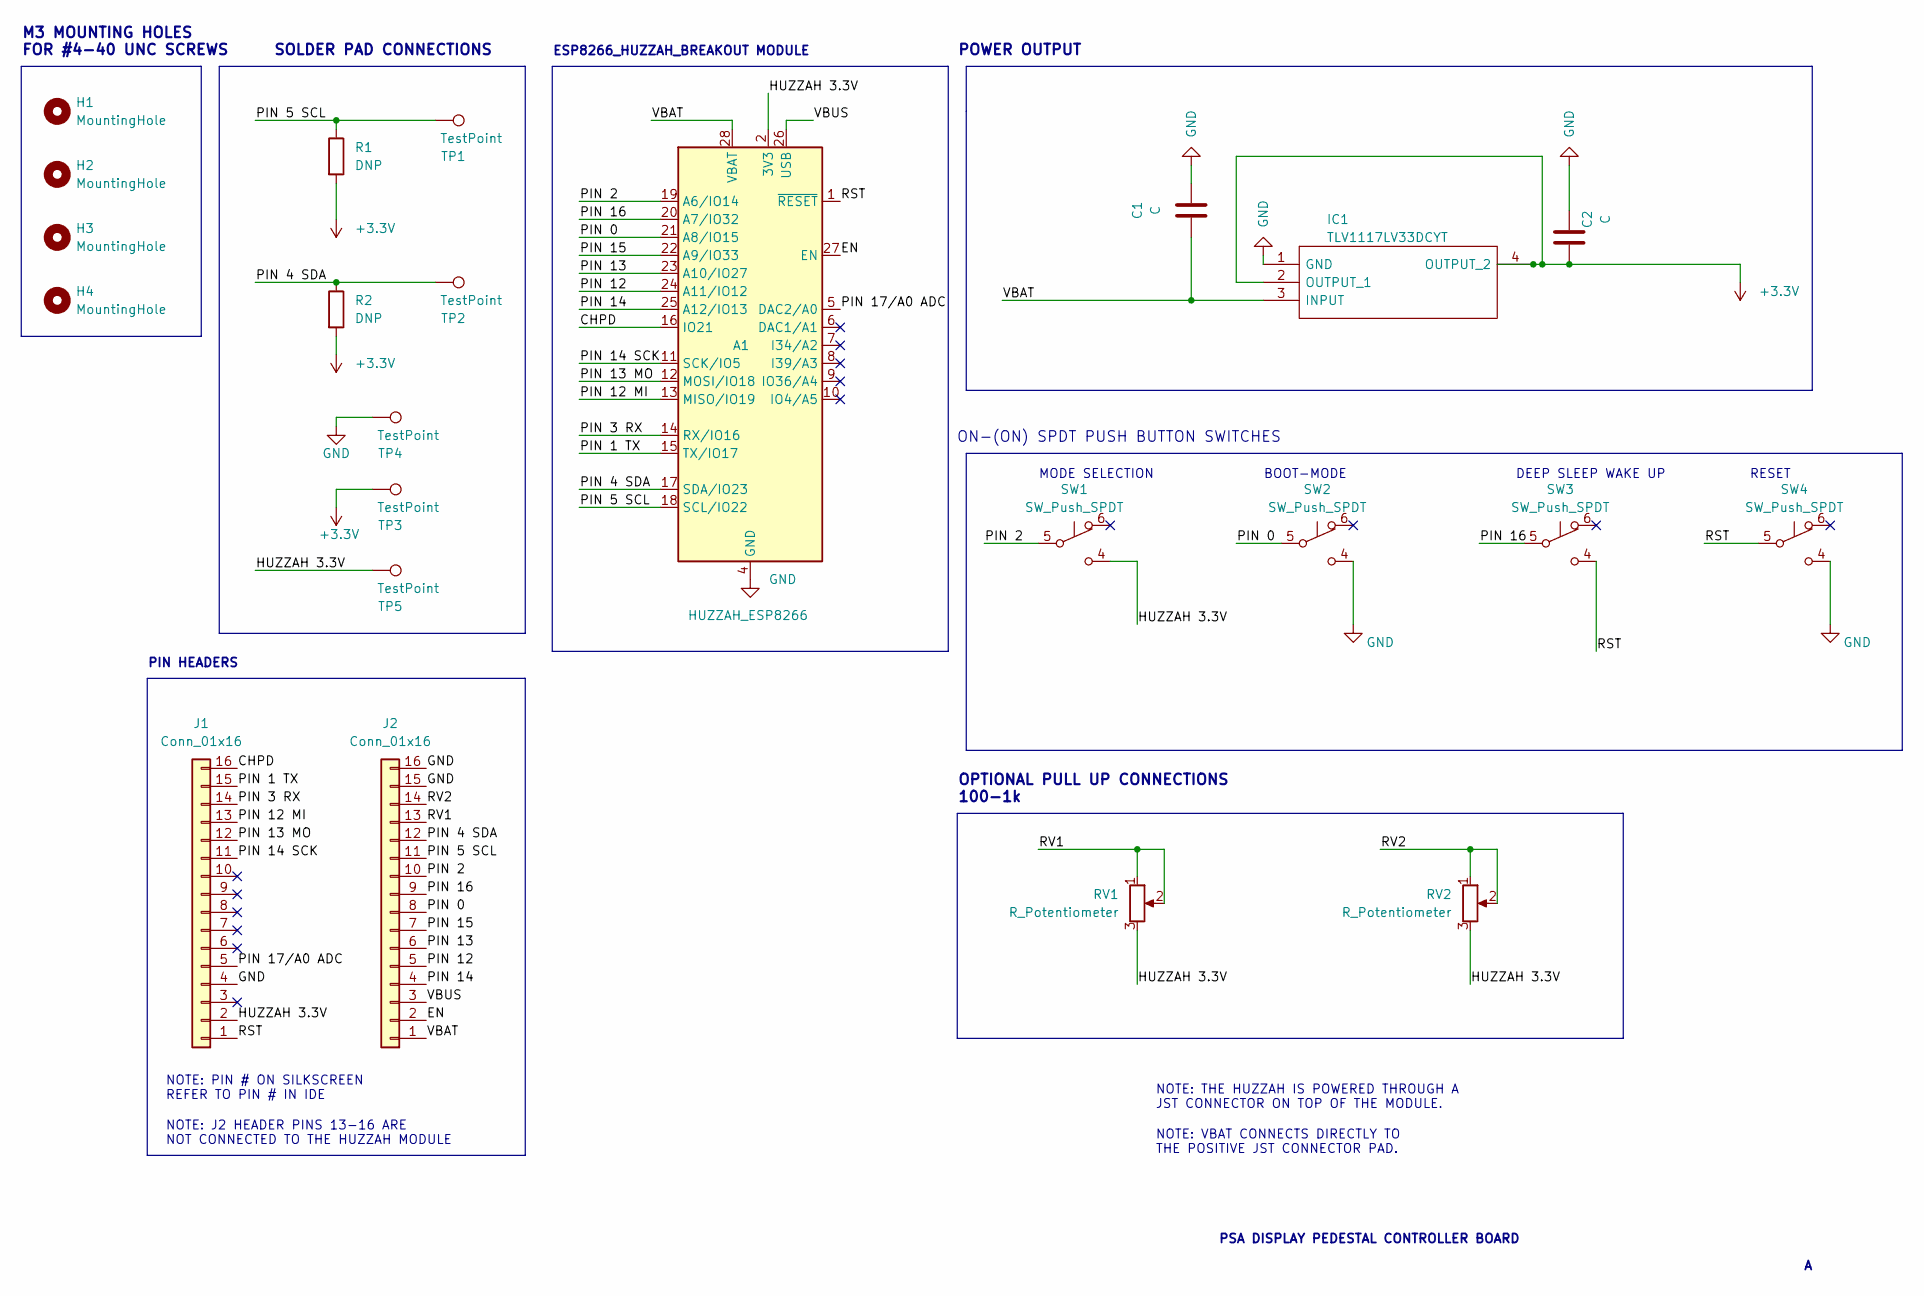
[picture p64: schematic HUZZAH_Breakout_PCB.kicad_sch]

Parts:
A1: HUZZAH_ESP8266; Adafruit_Feather
C1, C2: C; C_0805_2012Metric_Pad1.18x1.45mm_HandSolder
H1, H2, H3, H4: MountingHole; MountingHole_3.2mm_M3
IC1: TLV1117LV33DCYT; SOT230P700X180-4N; Mouser Part Number 595-TLV1117LV33DCYT
J1, J2: Conn_01x16; PinHeader_1x16_P2.54mm_Vertical
R1, R2: DNP; R_0805_2012Metric_Pad1.20x1.40mm_HandSolder
RV1, RV2: R_Potentiometer; 3352T1104LF
SW1, SW2, SW3, SW4: SW_Push_SPDT; SW_NKK_GW12LJP
TP1, TP2, TP3, TP4, TP5: TestPoint; SolderWirePad_1x01_SMD_5x10mm

Connections:
+3.3V: C2.1, IC1.2 (OUTPUT_1), IC1.4 (OUTPUT_2), R1.2, R2.2, TP3.1
/CHPD: A1.16 (IO21), J1.16
/EN: A1.27 (EN), J2.2
/HUZZAH 3.3V: A1.2 (3V3), J1.2, RV1.3, RV2.3, SW1.4 (C), TP5.1
/PIN 0: A1.21 (A8/IO15), J2.8, SW2.5 (B)
/PIN 1 TX: A1.15 (TX/IO17), J1.15
/PIN 2: A1.19 (A6/IO14), J2.10, SW1.5 (B)
/PIN 3 RX: A1.14 (RX/IO16), J1.14
/PIN 4 SDA: A1.17 (SDA/IO23), J2.12, R2.1, TP2.1
/PIN 5 SCL: A1.18 (SCL/IO22), J2.11, R1.1, TP1.1
/PIN 12: A1.24 (A11/IO12), J2.5
/PIN 12 MI: A1.13 (MISO/IO19), J1.13
/PIN 13: A1.23 (A10/IO27), J2.6
/PIN 13 MO: A1.12 (MOSI/IO18), J1.12
/PIN 14: A1.25 (A12/IO13), J2.4
/PIN 14 SCK: A1.11 (SCK/IO5), J1.11
/PIN 15: A1.22 (A9/IO33), J2.7
/PIN 16: A1.20 (A7/IO32), J2.9, SW3.5 (B)
/PIN 17/A0 ADC: A1.5 (DAC2/A0), J1.5
/RST: A1.1 (~RESET), J1.1, SW3.4 (C), SW4.5 (B)
/RV1: J2.13, RV1.1, RV1.2
/RV2: J2.14, RV2.1, RV2.2
/VBAT: A1.28 (VBAT), C1.2, IC1.3 (INPUT), J2.1
/VBUS: A1.26 (USB), J2.3
GND: A1.4 (GND), C1.1, C2.2, IC1.1 (GND), J1.4, J2.15, J2.16, SW2.4 (C), SW4.4 (C), TP4.1

Notes on the sheet:
PSA DISPLAY PEDESTAL CONTROLLER BOARD
RESET
BOOT-MODE
SOLDER PAD CONNECTIONS
POWER OUTPUT
OPTIONAL PULL UP CONNECTIONS 100-1k
MODE SELECTION
ESP8266_HUZZAH_BREAKOUT MODULE
NOTE: J2 HEADER PINS 13-16 ARE NOT CONNECTED TO THE HUZZAH MODULE
NOTE: PIN # ON SILKSCREEN REFER TO PIN # IN IDE
PIN HEADERS
NOTE: THE HUZZAH IS POWERED THROUGH A JST CONNECTOR ON TOP OF THE MODULE.
DEEP SLEEP WAKE UP
ON-(ON) SPDT PUSH BUTTON SWITCHES
NOTE: VBAT CONNECTS DIRECTLY TO THE POSITIVE JST CONNECTOR PAD.
M3 MOUNTING HOLES FOR #4-40 UNC SCREWS

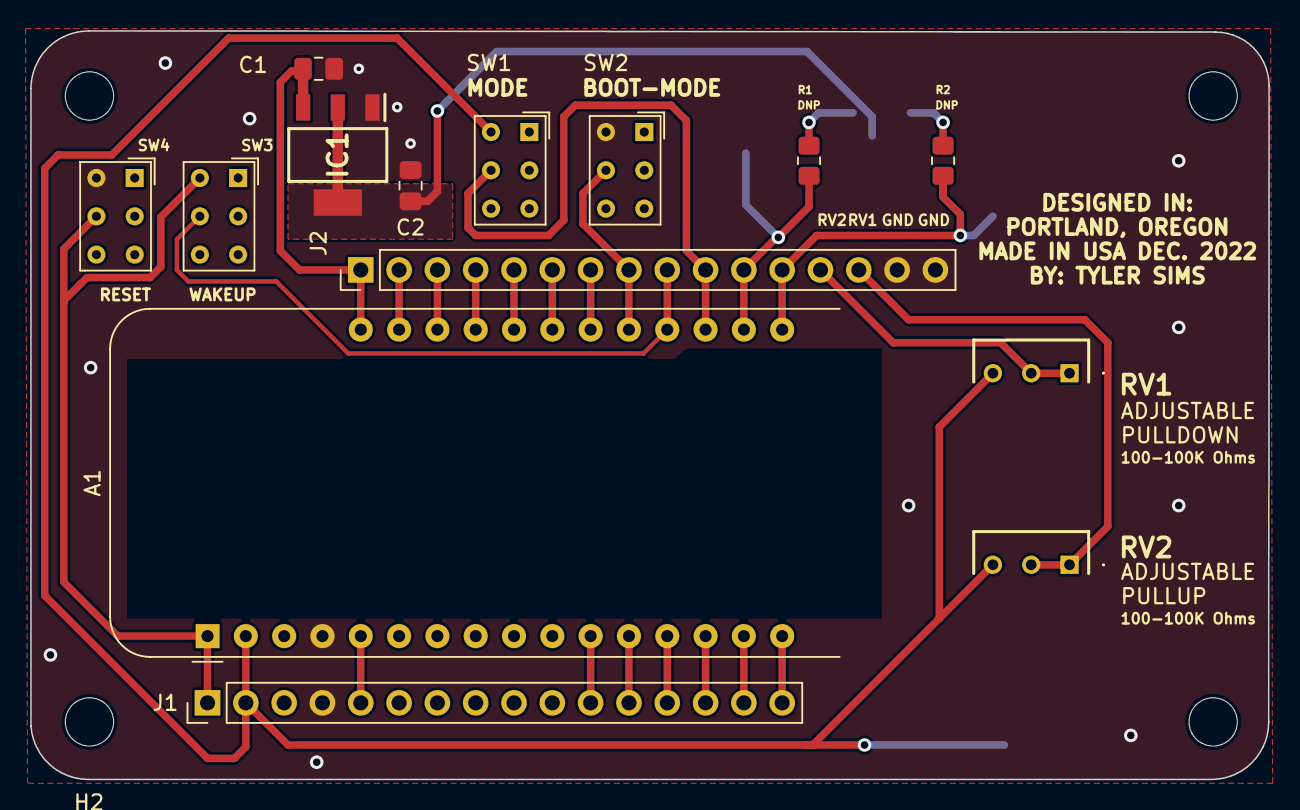
[picture p65: board HUZZAH_Breakout_PCB.kicad_pcb from above]

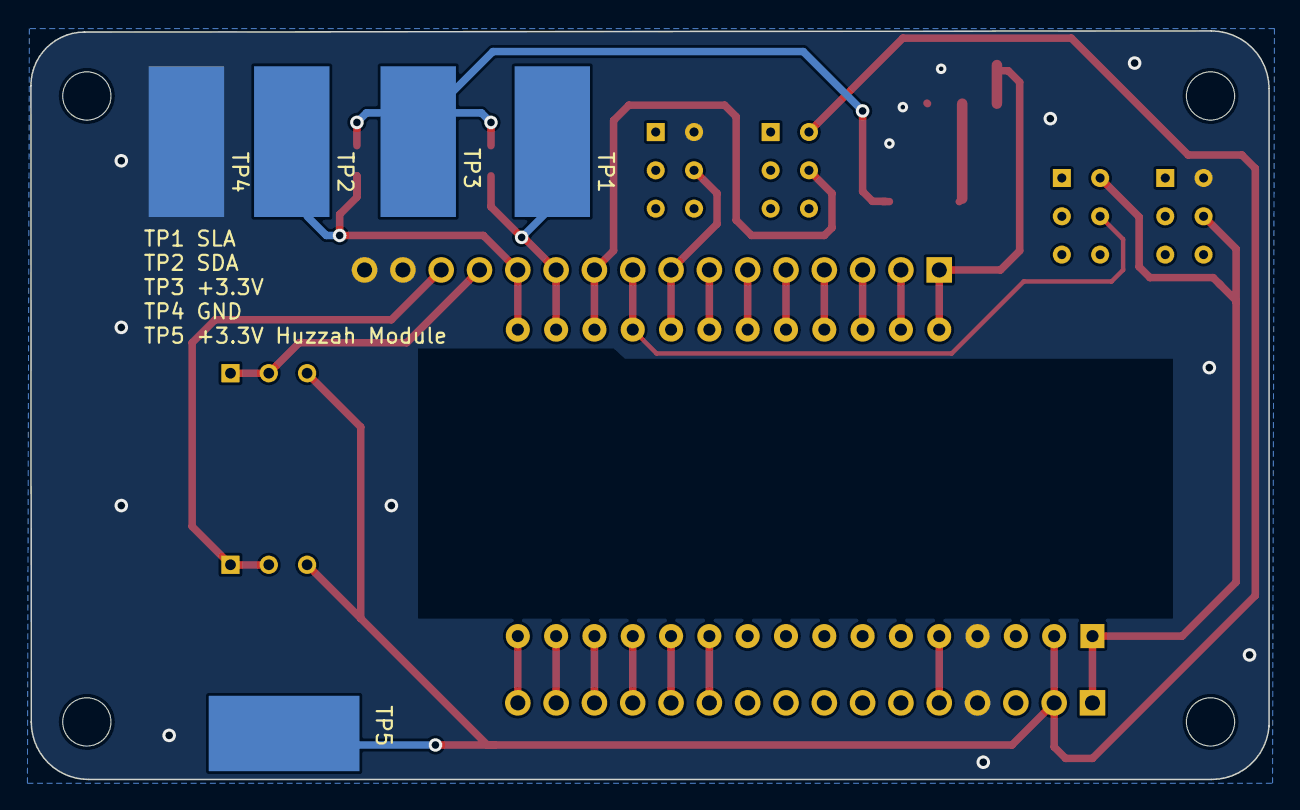
[picture p66: board HUZZAH_Breakout_PCB.kicad_pcb from below]

Board: 2 copper layers, 82.1 x 49.6 mm, 23 parts (5 on the bottom side), 25 nets.
