tylerssims/psa_display_pedestal/psa_display_pedestal/printed_circuit_boards/front_panel_display_pcb/psa_display_pcb/PSA_Display_PCB.kicad_pcb

## KiCad design psa_display_pedestal/printed_circuit_boards/front_panel_display_pcb/psa_display_pcb/PSA_Display_PCB.kicad_pcb (2023-03-03)

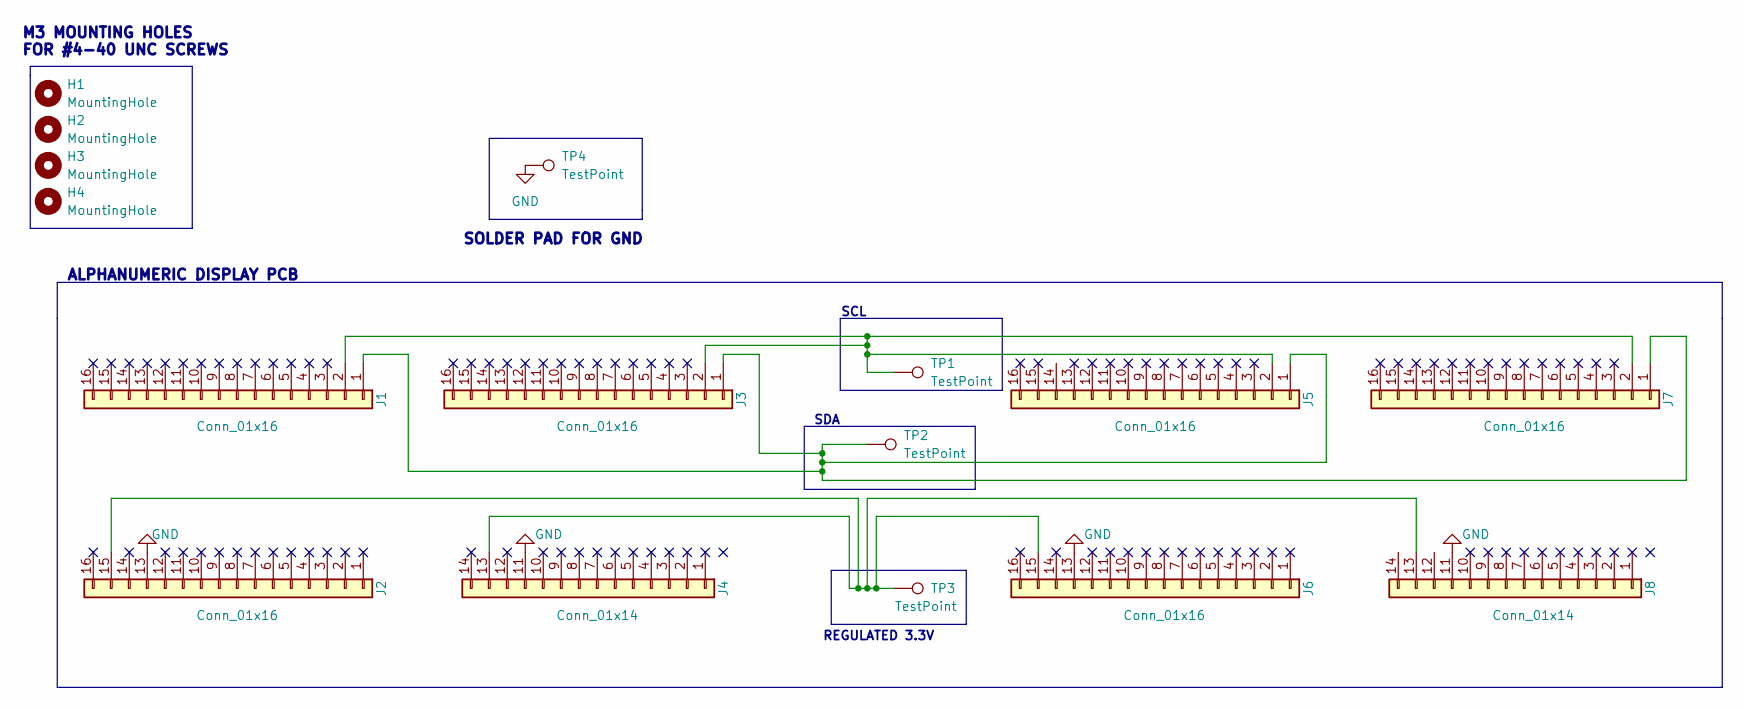
[picture p67: schematic PSA_Display_PCB.kicad_sch]

Parts:
H1, H2, H3, H4: MountingHole; MountingHole_3.2mm_M3
J1, J2, J3, J5, J6, J7: Conn_01x16; PinHeader_1x16_P2.54mm_Vertical
J4, J8: Conn_01x14; PinHeader_1x14_P2.54mm_Vertical
TP1, TP2, TP3, TP4: TestPoint; SolderWirePad_1x01_SMD_5x10mm

Connections:
GND: J2.13, J4.11, J6.13, J8.11, TP4.1
unnamed: J2.15, J4.13, J6.15, J8.13, TP3.1
unnamed: J1.2, J3.2, J5.2, J7.2, TP1.1
unnamed: J1.1, J3.1, J5.1, J7.1, TP2.1

Notes on the sheet:
SDA
ALPHANUMERIC DISPLAY PCB
SCL
M3 MOUNTING HOLES FOR #4-40 UNC SCREWS
REGULATED 3.3V
SOLDER PAD FOR GND

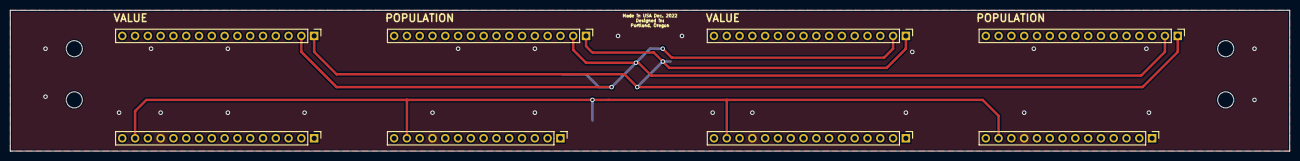
[picture p68: board PSA_Display_PCB.kicad_pcb from above]

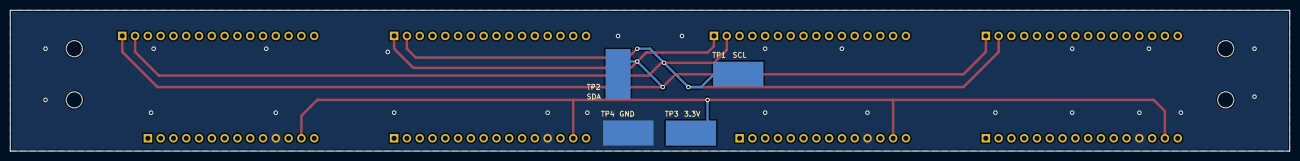
[picture p69: board PSA_Display_PCB.kicad_pcb from below]

Board: 2 copper layers, 254.0 x 27.9 mm, 16 parts (4 on the bottom side), 4 nets.
